yusufElnady/Ultrasound-Auxiliary-Board/BOMs/Sample-BOM_JLCSMT.xlsx

Designator | Footprint | Manufacturer Part Number
C1,C13,C20,C21,C28,C29 | Capacitor_SMD:C_0603_1608Metric | CL10A106KP8NNNC
C2,C3,C4,C9,C10,C11,C12,C16,C17,C18,C19,C22,C23,C24,C25,C26,C27,C30,C31,C32,C33,C34,C39,C49,C52,C54,C55,C56,C58,C89,C90,C96,C100,C103,C112,C113,C114,C115,C116,C117,C40,C41,C42,C43,C44,C45,C46,C69,C72,C73,C74,C75,C76,C77,C78,C79,C80,C81,C82,C83,C84,C85,C86,C111 | Capacitor_SMD:C_0603_1608Metric | CC0603KRX7R9BB104
C5,C6,C7,C8 | Capacitor_SMD:C_0603_1608Metric | CL10B105KP8NNNC
C14,C15 | Capacitor_SMD:C_0603_1608Metric | GRM1885C1H330JA01D
C35,C36,C37,C38,C57,C60,C63,C66 | Capacitor_SMD:C_0603_1608Metric | CL10C220JB8NNNC
C47,C48,C67,C68 | Capacitor_SMD:C_0603_1608Metric | CL10B223KB8NNNC
C50,C51,C61,C105 | Capacitor_SMD:C_0603_1608Metric | CL10B224KB8NNNC
C87 | Capacitor_SMD:C_1210_3225Metric | GRM32ER61C476KE15L
C88,C91,C92,C97,C98,C104,C109 | Capacitor_SMD:C_0805_2012Metric | CL21A106KAYNNNE
C93,C99,C101,C102,C107,C110 | Capacitor_SMD:C_0805_2012Metric | CL21A226MAYNNNE
C94 | Capacitor_SMD:C_0603_1608Metric | CL10B105KP8NNNC
C95 | Capacitor_SMD:C_0805_2012Metric | CL21A475KAQNNNE
C106 | Capacitor_SMD:C_0603_1608Metric | CL10B472KB8NNNC
C108 | Capacitor_SMD:C_0603_1608Metric | CL10C100JB8NNNC
D1,D2,D4,D5,D6,D7,D8 | LED_SMD:LED_0805_2012Metric | 17-21/GHC-YR1S2/4T
D3 | digikey-footprints:DO-214AC | B240A-13-F
D9,D10,D11,D12 | ESD8104MUTAG:DIO_ESD8104MUTAG | ESD8104MUTAG
F1 | 0154001.DR:FUSE_0154001.DR | 0154001.DR
J1,J2,J18,J19,J20,J21,J22,J23,J24,J25,J27 | Connector_PinHeader_2.54mm:PinHeader_1x02_P2.54mm_Vertical | PZ254V-11-02P
J3,J4,J5,J6,J7,J8,J9,J10 | CONSMA002-SMD:TE_CONSMA002-SMD | CONSMA002-SMD
J11 | Connector_PinHeader_2.54mm:PinHeader_1x03_P2.54mm_Vertical | PZ254V-11-03P
J12 | Connector_PinHeader_2.54mm:PinHeader_1x03_P2.54mm_Vertical | PZ254V-11-03P
J13 | digikey-footprints:PinHeader_1x3_P2.5mm_Drill1.1mm | PZ254V-11-03P
J14 | digikey-footprints:PinHeader_1x3_P2.5mm_Drill1.1mm | PZ254V-11-03P
J15 | Connector_PinHeader_2.54mm:PinHeader_1x07_P2.54mm_Vertical | PZ254V-11-07P
J16,J28 | Connector_PinHeader_2.54mm:PinHeader_2x04_P2.54mm_Vertical | PZ2.54V-1208P-H25
J17 | TerminalBlock:TerminalBlock_MaiXu_MX126-5.0-02P_1x02_P5.00mm | MX126-5.0-02P-GN01-Cu-S-A
J26 | Connector_PinHeader_2.54mm:PinHeader_1x02_P2.54mm_Vertical | PZ254V-11-02P
L1,L2,L3,L4 | Inductor_SMD:L_0805_2012Metric | MLF2012C101KT000
L5 | Inductor_SMD:L_0805_2012Metric | LQM21PN4R7MGRD
PS1,PS3 | TPSM84338RCJR:CONV_TPSM84338RCJR | TPSM84338RCJR
R1 | Resistor_SMD:R_0603_1608Metric | RP0603BRD0725RL
R2 | Resistor_SMD:R_0603_1608Metric | RC0603FR-07390RL
R3,R21,R22,R49,R50,R23,R24,R106,R115 | Resistor_SMD:R_0603_1608Metric | RC0603FR-0710KL
R4,R5,R6,R7,R8,R9,R10,R11,R12,R13,R14,R15,R16,R17,R18,R19,R31,R25,R26,R27,R28,R29,R30,R48,R101,R102,R83,R85,R87,R88,R91,R92,R97,R98,R110,R136,R137,R144,R146,R156 | Resistor_SMD:R_0603_1608Metric | RC0603FR-071KL
R20 | Resistor_SMD:R_0603_1608Metric | RC0603FR-072K2L
R32,R33,R34,R35,R44,R45,R46,R47 | Resistor_SMD:R_0603_1608Metric | CRCW0603280RFKEA
R36,R37,R42,R43,R141 | Resistor_SMD:R_0603_1608Metric | RC0603FR-07499RL
R38,R40,R41,R120,R121,R122,R123,R124,R125,R126,R127,R128,R129,R130,R131,R132,R133,R134,R135,R39 | Resistor_SMD:R_0603_1608Metric | CRCW060391R0FKEA
R51,R52,R55,R56,R59,R60,R62,R63,R67,R68,R70,R71,R78,R79,R81,R82 | Resistor_SMD:R_0603_1608Metric | RC0603FR-072K7L
R53,R54,R57,R58,R61,R64,R65,R66,R69,R72,R73,R74,R75,R76,R77,R80 | Resistor_SMD:R_0603_1608Metric | 0603WAF3901T5E
R84,R86,R89,R90,R93,R94,R95,R96 | Resistor_SMD:R_0603_1608Metric | 0603WAF2200T5E
R99,R100,R103,R104 | Resistor_SMD:R_0603_1608Metric | RT0603BRD073K57L
R105 | Resistor_SMD:R_0603_1608Metric | FRC0603F1073TS
R107,R112,R138 | Resistor_SMD:R_0603_1608Metric | 0603WAF2001T5E
R108,R111,R142,R143,R145,R154,R155 | Resistor_SMD:R_0603_1608Metric | RC0603FR-073KL
R109,R113 | Resistor_SMD:R_0603_1608Metric | RC0603FR-0718KL
R114 | Resistor_SMD:R_0603_1608Metric | AR03BTCX7202N
R116 | Resistor_SMD:R_0603_1608Metric | RC0603FR-0710RL
R117 | Resistor_SMD:R_0603_1608Metric | RT0603BRD07619KL
R118 | Resistor_SMD:R_0603_1608Metric | RC0603FR-07150KL
R119,R153 | Resistor_SMD:R_0603_1608Metric | RC0603FR-07100KL
R139,R140 | Resistor_SMD:R_0603_1608Metric | 0603WAF3300T5E
SW1 | Button_Switch_SMD:SW_Push_SPST_NO_Alps_SKRK | SH-TS-1185-2P-160gf
TP1,TP2,TP3,TP4,TP8,TP23,TP32,TP36,TP40,TP44,TP45,TP52,TP54,TP60,TP73,TP74,TP75,TP76,TP77,TP78,TP79 | digikey-footprints:PROBE_PAD_0805 | RCT-0C
U1,U4 | AD8334ACPZ:QFN50P900X900X100-65N | AD8334ACPZ
U2 | DSC1001DI2-125.0000T:CDFN4_2P5X2_MCH | DSC1001DI2-125.0000T
U3 | MAX14808ETK_:QFN50P1000X1000X80-69N | MAX14808ETK_
U5 | F280025PNS:PQFP_025PNSR_TEX | F280025PNS
U6 | Package_TO_SOT_SMD:SOT-23 | REF3030
U7 | MIC920YC5-TR:SOT65P210X110-5N | MIC920YC5-TR
U8,U9,U10,U11 | TLV9354IDR:SOIC_9354IDR_TEX | TLV9354IDR
U12 | TPS63700DRCR:VREG_V62_16624-01YE | TPS63700DRCR
U13 | M24M01E-FMN6TP:SO8N_4X5X1P27_STM | M24M01E-FMN6TP
U14 | LDL212PU50R:DFN_2PU50R_STM | LDL212PU50R
U15,U16 | Package_TO_SOT_SMD:SOT-223-3_TabPin2 | AZ1117CH2-3.3
U17 | TRS3221EIPWR:SOP65P640X120-16N | TRS3221EIPWR
U18,U19,U20 | BZX84C3V3TS-7-F:SOT-363_DIO | BZX84C3V3TS-7-F
U22,U23 | SOT_C3.3DT5G_ONS | ESD7C3.3DT5G
Y2 | KiCad:H130B16000183030EXTTR | H130B-16.000-18-3030-EXT-TR
