yusufElnady/Ultrasound-Auxiliary-Board/Ultrasound_NDT.kicad_pcb

## KiCad design Ultrasound_NDT.kicad_pcb (2026-05-07)

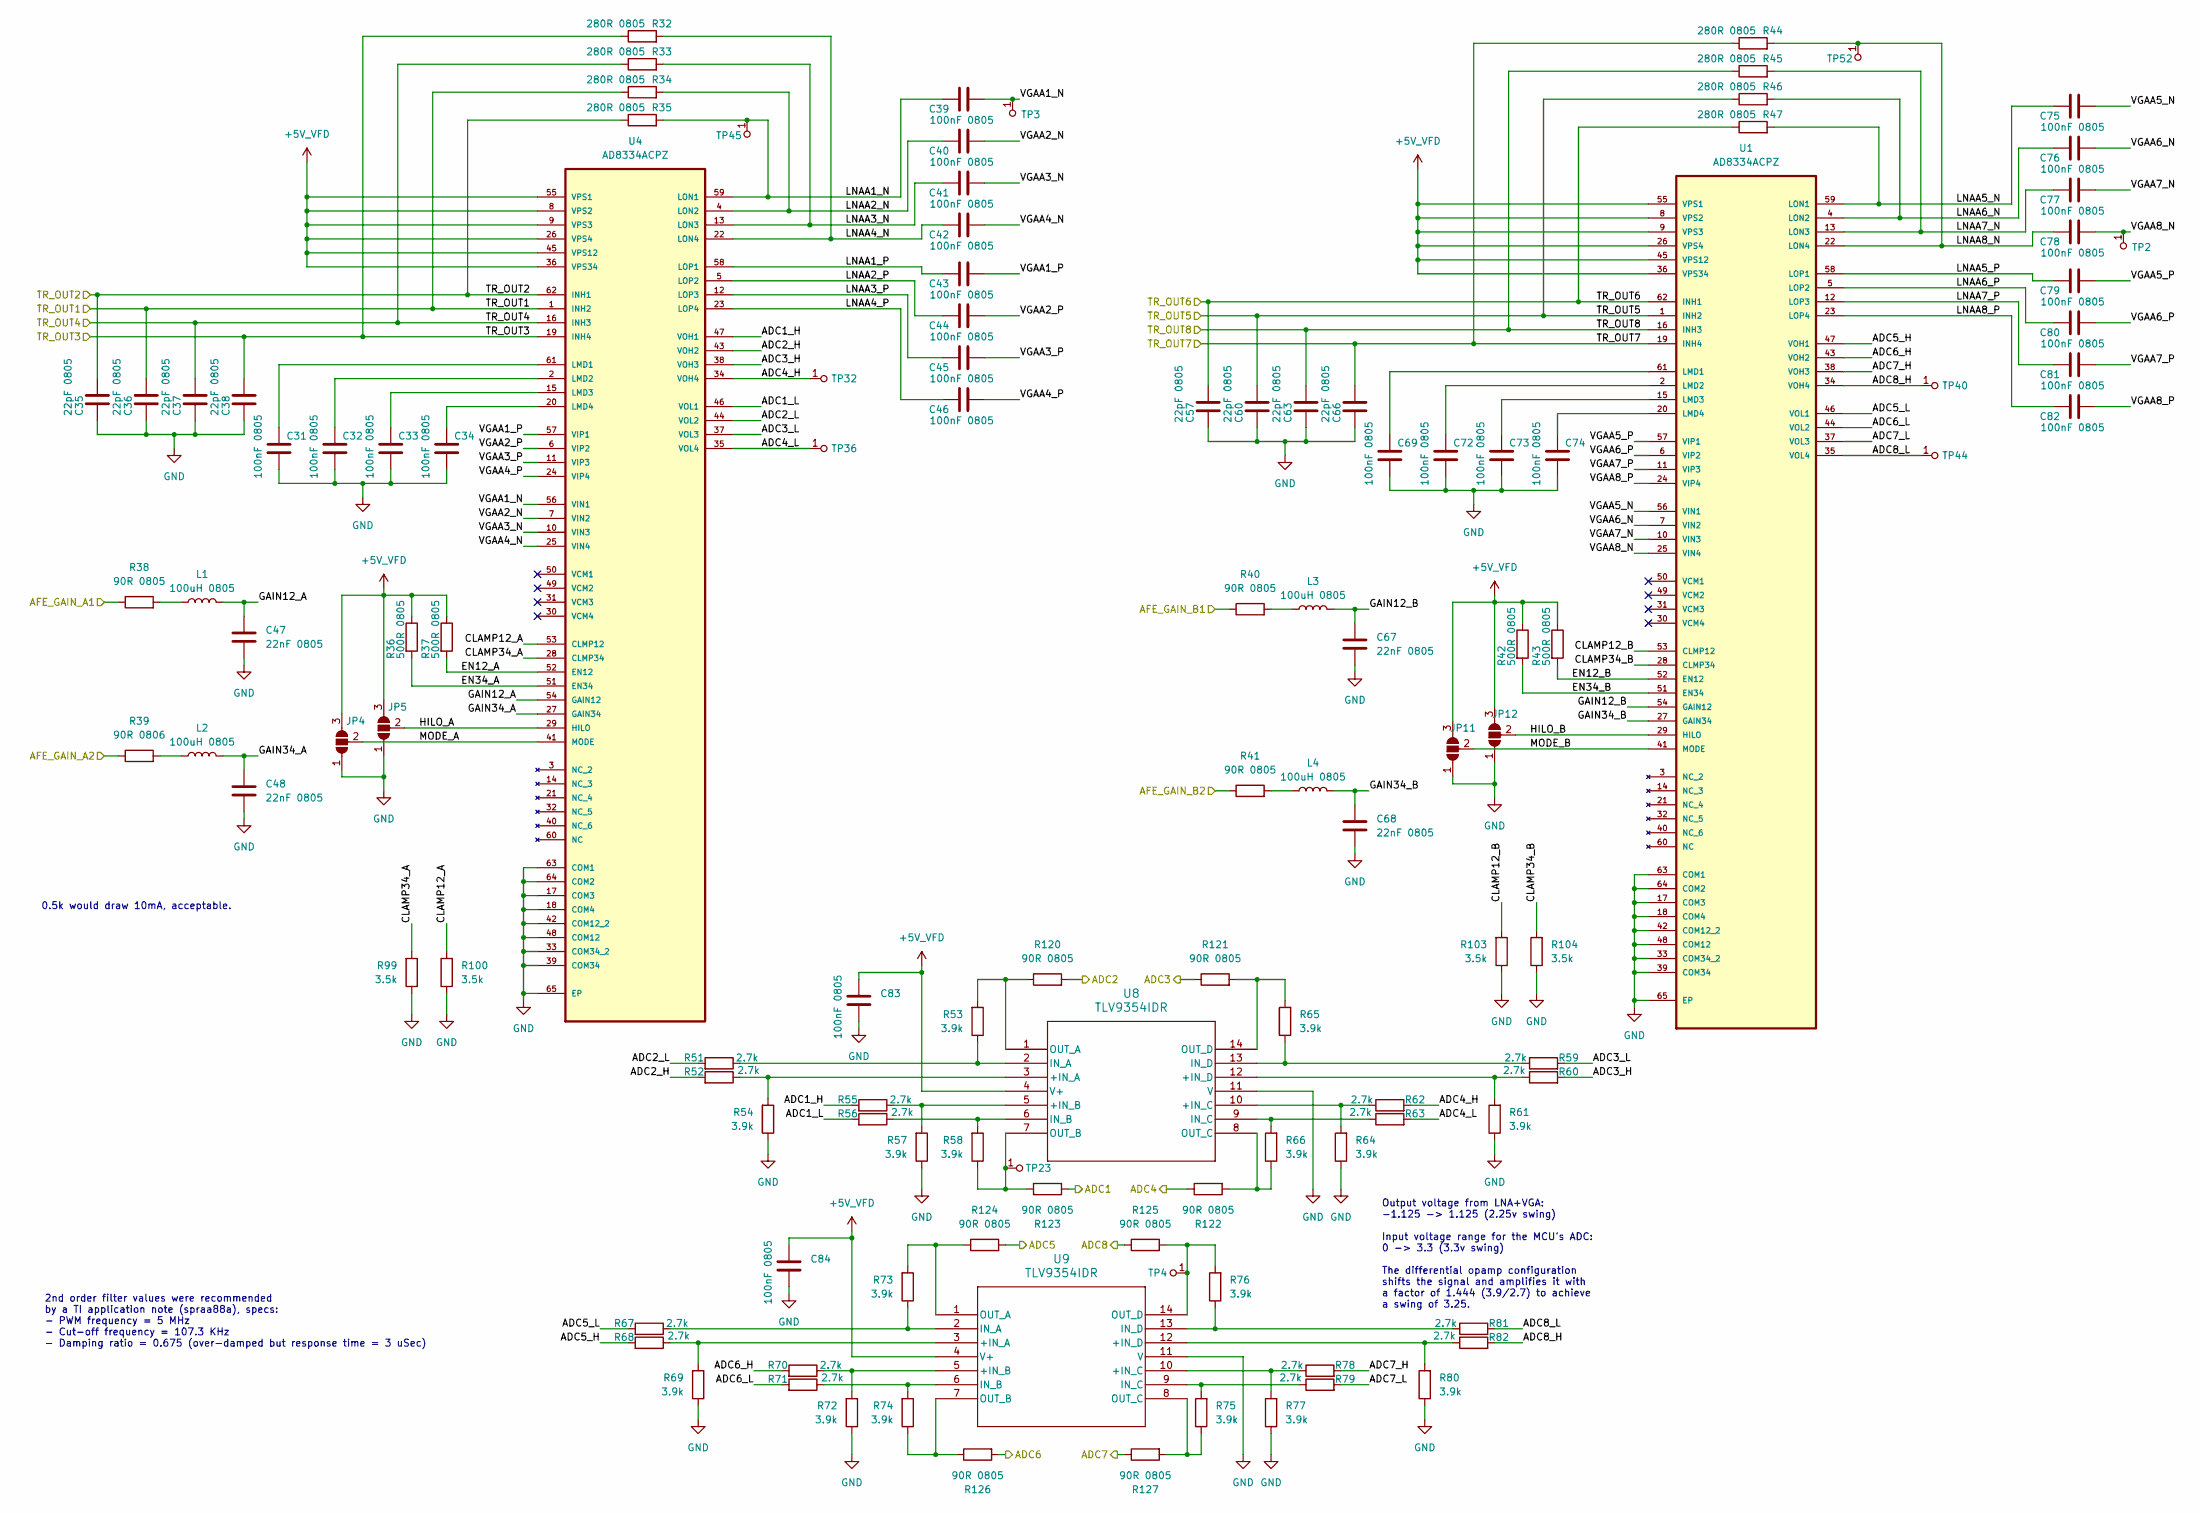
[picture p6: schematic receiver.kicad_sch]

Parts:
C31, C32, C33, C34, C39, C40, C41, C42, C43, C44, C45, C46, C69, C72, C73, C74, C75, C76, C77, C78, C79, C80, C81, C82, C83, C84: 100nF 0805; C_0603_1608Metric
C35, C36, C37, C38, C57, C60, C63, C66: 22pF 0805; C_0603_1608Metric
C47, C48, C67, C68: 22nF 0805; C_0603_1608Metric
JP4, JP5, JP11, JP12: SolderJumper_3_Open; SolderJumper-3_P1.3mm_Open_Pad1.0x1.5mm
L1, L2, L3, L4: 100uH 0805; L_0805_2012Metric
R32, R33, R34, R35, R44, R45, R46, R47: 280R 0805; R_0603_1608Metric
R36, R37, R42, R43: 500R 0805; R_0603_1608Metric
R38, R40, R41, R120, R121, R122, R123, R124, R125, R126, R127: 90R 0805; R_0603_1608Metric
R39: 90R 0806; R_0603_1608Metric
R51, R52, R55, R56, R59, R60, R62, R63, R67, R68, R70, R71, R78, R79, R81, R82: 2.7k; R_0603_1608Metric
R53, R54, R57, R58, R61, R64, R65, R66, R69, R72, R73, R74, R75, R76, R77, R80: 3.9k; R_0603_1608Metric
R99, R100, R103, R104: 3.5k; R_0603_1608Metric
TP2, TP3, TP4, TP23, TP32, TP36, TP40, TP44, TP45, TP52: RCT-0C; PROBE_PAD_0805; MPN RCT-0C; Digi-Key_PN A106144CT-ND
U1, U4: AD8334ACPZ; QFN50P900X900X100-65N; MPN AD8334ACPZ
U8, U9: TLV9354IDR; SOIC_9354IDR_TEX

Connections:
+5V_VFD: C83.1, C84.1, JP4.3 (B), JP5.3 (B), JP11.3 (B), JP12.3 (B), R36.1, R37.1, R42.1, R43.1, U1.8 (VPS2), U1.9 (VPS3), U1.26 (VPS4), U1.36 (VPS34), U1.45 (VPS12), U1.55 (VPS1), U4.8 (VPS2), U4.9 (VPS3), U4.26 (VPS4), U4.36 (VPS34), U4.45 (VPS12), U4.55 (VPS1), U8.4 (V+), U9.4 (V+); also elsewhere on the board
/Main MCU Section/ADC1: R123.2; also elsewhere on the board
/Main MCU Section/ADC2: R120.2; also elsewhere on the board
/Main MCU Section/ADC3: R121.1; also elsewhere on the board
/Main MCU Section/ADC4: R122.1; also elsewhere on the board
/Main MCU Section/ADC5: R124.2; also elsewhere on the board
/Main MCU Section/ADC6: R126.2; also elsewhere on the board
/Main MCU Section/ADC7: R127.1; also elsewhere on the board
/Main MCU Section/ADC8: R125.1; also elsewhere on the board
/Main MCU Section/AFE_GAIN_A1: R38.1; also elsewhere on the board
/Main MCU Section/AFE_GAIN_A2: R39.1; also elsewhere on the board
/Main MCU Section/AFE_GAIN_B1: R40.1; also elsewhere on the board
/Main MCU Section/AFE_GAIN_B2: R41.1; also elsewhere on the board
/Receiving Section/ADC1_H: R55.2, U4.47 (VOH1)
/Receiving Section/ADC1_L: R56.2, U4.46 (VOL1)
/Receiving Section/ADC2_H: R52.2, U4.43 (VOH2)
/Receiving Section/ADC2_L: R51.2, U4.44 (VOL2)
/Receiving Section/ADC3_H: R60.2, U4.38 (VOH3)
/Receiving Section/ADC3_L: R59.2, U4.37 (VOL3)
/Receiving Section/ADC4_H: R62.2, TP32.1, U4.34 (VOH4)
/Receiving Section/ADC4_L: R63.2, TP36.1, U4.35 (VOL4)
/Receiving Section/ADC5_H: R68.2, U1.47 (VOH1)
/Receiving Section/ADC5_L: R67.2, U1.46 (VOL1)
/Receiving Section/ADC6_H: R70.2, U1.43 (VOH2)
/Receiving Section/ADC6_L: R71.2, U1.44 (VOL2)
/Receiving Section/ADC7_H: R78.2, U1.38 (VOH3)
/Receiving Section/ADC7_L: R79.2, U1.37 (VOL3)
/Receiving Section/ADC8_H: R82.2, TP40.1, U1.34 (VOH4)
/Receiving Section/ADC8_L: R81.2, TP44.1, U1.35 (VOL4)
/Receiving Section/CLAMP12_A: R100.2, U4.53 (CLMP12)
/Receiving Section/CLAMP12_B: R103.2, U1.53 (CLMP12)
/Receiving Section/CLAMP34_A: R99.2, U4.28 (CLMP34)
/Receiving Section/CLAMP34_B: R104.2, U1.28 (CLMP34)
/Receiving Section/EN12_A: R37.2, U4.52 (EN12)
/Receiving Section/EN12_B: R43.2, U1.52 (EN12)
/Receiving Section/EN34_A: R36.2, U4.51 (EN34)
/Receiving Section/EN34_B: R42.2, U1.51 (EN34)
/Receiving Section/GAIN12_A: C47.1, L1.2, U4.54 (GAIN12)
/Receiving Section/GAIN12_B: C67.1, L3.2, U1.54 (GAIN12)
/Receiving Section/GAIN34_A: C48.1, L2.2, U4.27 (GAIN34)
/Receiving Section/GAIN34_B: C68.1, L4.2, U1.27 (GAIN34)
/Receiving Section/HILO_A: JP5.2 (C), U4.29 (HILO)
/Receiving Section/HILO_B: JP12.2 (C), U1.29 (HILO)
/Receiving Section/LNAA1_N: C39.1, R35.2, TP45.1, U4.59 (LON1)
/Receiving Section/LNAA1_P: C43.1, U4.58 (LOP1)
/Receiving Section/LNAA2_N: C40.1, R34.2, U4.4 (LON2)
/Receiving Section/LNAA2_P: C44.1, U4.5 (LOP2)
/Receiving Section/LNAA3_N: C41.1, R33.2, U4.13 (LON3)
/Receiving Section/LNAA3_P: C45.1, U4.12 (LOP3)
/Receiving Section/LNAA4_N: C42.1, R32.2, U4.22 (LON4)
/Receiving Section/LNAA4_P: C46.1, U4.23 (LOP4)
/Receiving Section/LNAA5_N: C75.1, R47.2, U1.59 (LON1)
/Receiving Section/LNAA5_P: C79.1, U1.58 (LOP1)
/Receiving Section/LNAA6_N: C76.1, R46.2, U1.4 (LON2)
/Receiving Section/LNAA6_P: C80.1, U1.5 (LOP2)
/Receiving Section/LNAA7_N: C77.1, R45.2, U1.13 (LON3)
/Receiving Section/LNAA7_P: C81.1, U1.12 (LOP3)
/Receiving Section/LNAA8_N: C78.1, R44.2, TP52.1, U1.22 (LON4)
/Receiving Section/LNAA8_P: C82.1, U1.23 (LOP4)
/Receiving Section/MODE_A: JP4.2 (C), U4.41 (MODE)
/Receiving Section/MODE_B: JP11.2 (C), U1.41 (MODE)
/Receiving Section/TR_OUT1: C36.1, R34.1, U4.1 (INH2); also elsewhere on the board
/Receiving Section/TR_OUT2: C35.1, R35.1, U4.62 (INH1); also elsewhere on the board
/Receiving Section/TR_OUT3: C38.1, R32.1, U4.19 (INH4); also elsewhere on the board
/Receiving Section/TR_OUT4: C37.1, R33.1, U4.16 (INH3); also elsewhere on the board
/Receiving Section/TR_OUT5: C60.1, R46.1, U1.1 (INH2); also elsewhere on the board
/Receiving Section/TR_OUT6: C57.1, R47.1, U1.62 (INH1); also elsewhere on the board
/Receiving Section/TR_OUT7: C66.1, R44.1, U1.19 (INH4); also elsewhere on the board
/Receiving Section/TR_OUT8: C63.1, R45.1, U1.16 (INH3); also elsewhere on the board
/Receiving Section/VGAA1_N: C39.2, TP3.1, U4.56 (VIN1)
/Receiving Section/VGAA1_P: C43.2, U4.57 (VIP1)
/Receiving Section/VGAA2_N: C40.2, U4.7 (VIN2)
/Receiving Section/VGAA2_P: C44.2, U4.6 (VIP2)
/Receiving Section/VGAA3_N: C41.2, U4.10 (VIN3)
/Receiving Section/VGAA3_P: C45.2, U4.11 (VIP3)
/Receiving Section/VGAA4_N: C42.2, U4.25 (VIN4)
/Receiving Section/VGAA4_P: C46.2, U4.24 (VIP4)
/Receiving Section/VGAA5_N: C75.2, U1.56 (VIN1)
/Receiving Section/VGAA5_P: C79.2, U1.57 (VIP1)
/Receiving Section/VGAA6_N: C76.2, U1.7 (VIN2)
/Receiving Section/VGAA6_P: C80.2, U1.6 (VIP2)
/Receiving Section/VGAA7_N: C77.2, U1.10 (VIN3)
/Receiving Section/VGAA7_P: C81.2, U1.11 (VIP3)
/Receiving Section/VGAA8_N: C78.2, TP2.1, U1.25 (VIN4)
/Receiving Section/VGAA8_P: C82.2, U1.24 (VIP4)
GND: C31.2, C32.2, C33.2, C34.2, C35.2, C36.2, C37.2, C38.2, C47.2, C48.2, C57.2, C60.2, C63.2, C66.2, C67.2, C68.2, C69.2, C72.2, C73.2, C74.2, C83.2, C84.2, JP4.1 (A), JP5.1 (A), JP11.1 (A), JP12.1 (A), R54.1, R57.1, R61.1, R64.1, R69.1, R72.1, R77.1, R80.1, R99.1, R100.1, R103.1, R104.1, U1.17 (COM3), U1.18 (COM4), U1.33 (COM34_2), U1.39 (COM34), U1.42 (COM12_2), U1.48 (COM12), U1.63 (COM1), U1.64 (COM2), U1.65 (EP), U4.17 (COM3), U4.18 (COM4), U4.33 (COM34_2), U4.39 (COM34), U4.42 (COM12_2), U4.48 (COM12), U4.63 (COM1), U4.64 (COM2), U4.65 (EP), U8.11 (V), U9.11 (V); also elsewhere on the board
unnamed: L1.1, R38.2
unnamed: L2.1, R39.2
unnamed: L3.1, R40.2
unnamed: L4.1, R41.2
unnamed: C69.1, U1.61 (LMD1)
unnamed: C72.1, U1.2 (LMD2)
unnamed: C73.1, U1.15 (LMD3)
unnamed: C74.1, U1.20 (LMD4)
unnamed: C31.1, U4.61 (LMD1)
unnamed: C32.1, U4.2 (LMD2)
unnamed: C33.1, U4.15 (LMD3)
unnamed: C34.1, U4.20 (LMD4)
unnamed: R52.1, R54.2, U8.3 (+IN_A)
unnamed: R55.1, R57.2, U8.5 (+IN_B)
unnamed: R62.1, R64.2, U8.10 (+IN_C)
unnamed: R60.1, R61.2, U8.12 (+IN_D)
unnamed: R51.1, R53.1, U8.2 (IN_A)
unnamed: R56.1, R58.2, U8.6 (IN_B)
unnamed: R63.1, R66.2, U8.9 (IN_C)
unnamed: R59.1, R65.1, U8.13 (IN_D)
unnamed: R53.2, R120.1, U8.1 (OUT_A)
unnamed: R58.1, R123.1, TP23.1, U8.7 (OUT_B)
unnamed: R66.1, R122.2, U8.8 (OUT_C)
unnamed: R65.2, R121.2, U8.14 (OUT_D)
unnamed: R68.1, R69.2, U9.3 (+IN_A)
unnamed: R70.1, R72.2, U9.5 (+IN_B)
unnamed: R77.2, R78.1, U9.10 (+IN_C)
unnamed: R80.2, R82.1, U9.12 (+IN_D)
unnamed: R67.1, R73.1, U9.2 (IN_A)
unnamed: R71.1, R74.2, U9.6 (IN_B)
unnamed: R75.2, R79.1, U9.9 (IN_C)
unnamed: R76.1, R81.1, U9.13 (IN_D)
unnamed: R73.2, R124.1, U9.1 (OUT_A)
unnamed: R74.1, R126.1, U9.7 (OUT_B)
unnamed: R75.1, R127.2, U9.8 (OUT_C)
unnamed: R76.2, R125.2, TP4.1, U9.14 (OUT_D)

Notes on the sheet:
Output voltage from LNA+VGA: -1.125 -> 1.125 (2.25v swing) Input voltage range for the MCU's ADC: 0 -> 3.3 (3.3v swing) The differential opamp configuration shifts the signal and amplifies it with a factor of 1.444 (3.9/2.7) to achieve a swing of 3.25.
2nd order filter values were recommended by a TI application note (spraa88a), specs: - PWM frequency = 5 MHz - Cut-off frequency = 107.3 KHz - Damping ratio = 0.675 (over-damped but response time = 3 uSec)
0.5k would draw 10mA, acceptable.

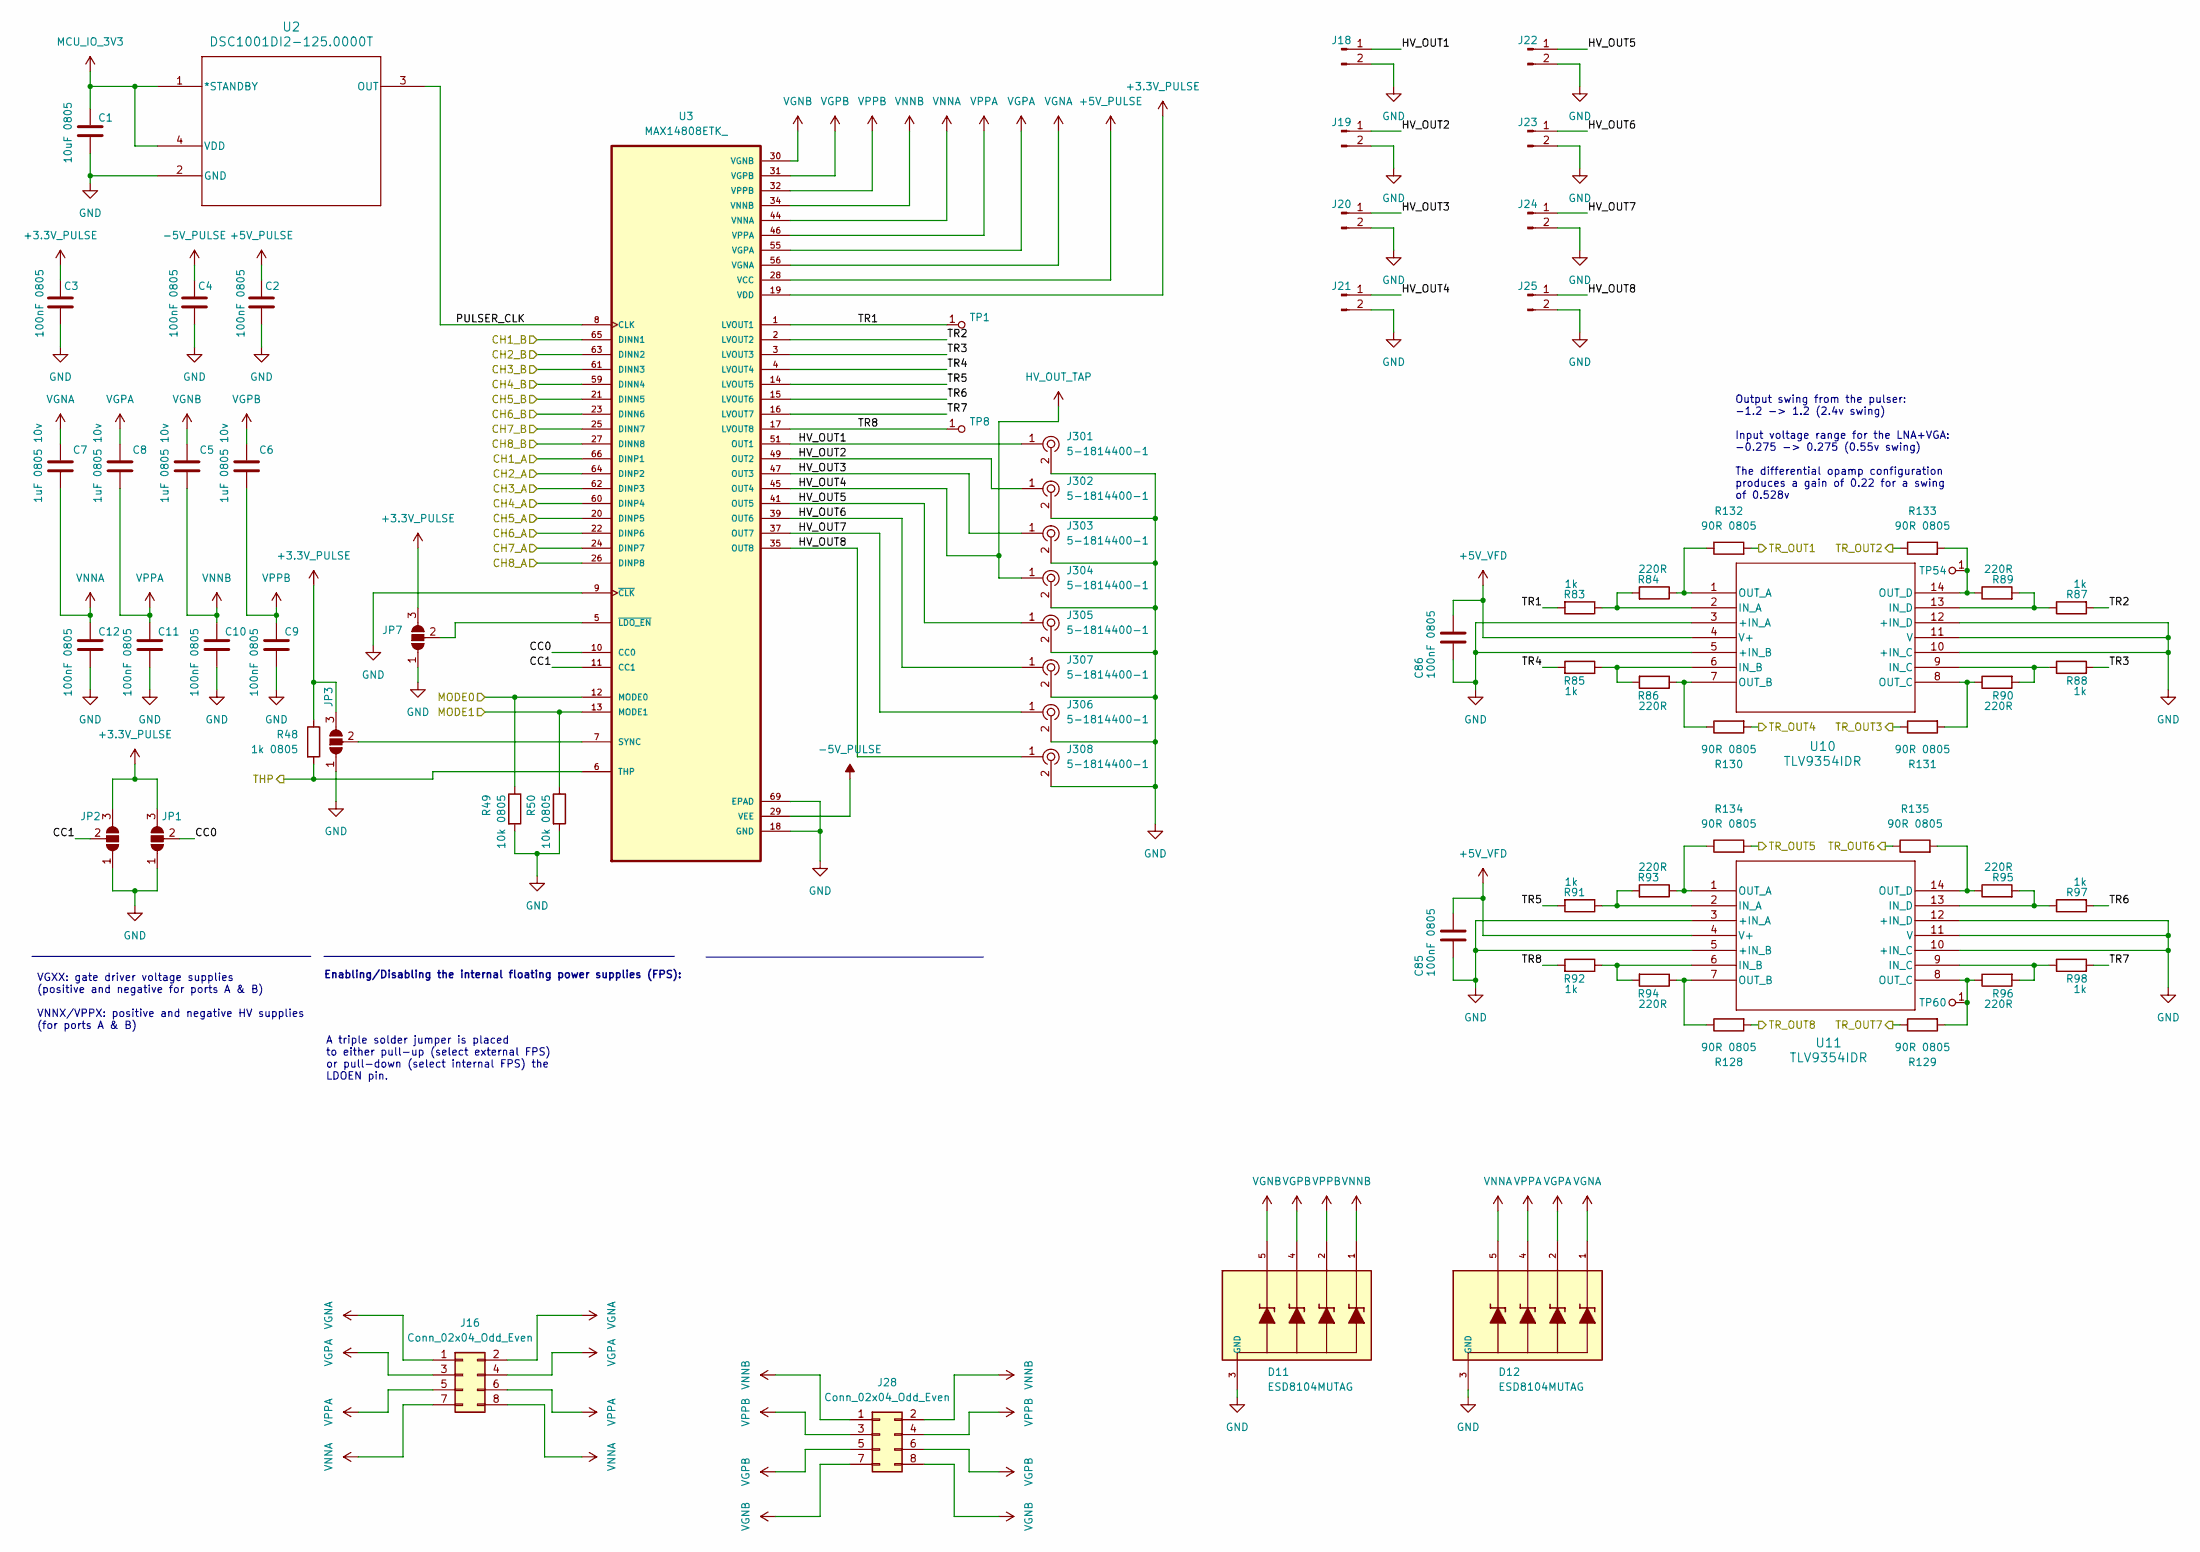
[picture p7: schematic pulser.kicad_sch]

Parts:
C1: 10uF 0805; C_0603_1608Metric
C2, C3, C4, C9, C10, C11, C12, C85, C86: 100nF 0805; C_0603_1608Metric
C5, C6, C7, C8: 1uF 0805 10v; C_0603_1608Metric
D11, D12: ESD8104MUTAG; DIO_ESD8104MUTAG; PARTREV 8
J16, J28: Conn_02x04_Odd_Even; PinHeader_2x04_P2.54mm_Vertical
J18, J19, J20, J21, J22, J23, J24, J25: Conn_01x02_Pin; PinHeader_1x02_P2.54mm_Vertical
J301, J302, J303, J304, J305, J306, J307, J308: 5-1814400-1; RF_SMA_RightAngle_5-1814400-1; MPN 5-1814400-1; Digi-Key_PN A97593-ND
JP1, JP2, JP3, JP7: SolderJumper_3_Open; SolderJumper-3_P1.3mm_Open_Pad1.0x1.5mm
R48: 1k 0805; R_0603_1608Metric
R49, R50: 10k 0805; R_0603_1608Metric
R83, R85, R87, R88, R91, R92, R97, R98: 1k; R_0603_1608Metric
R84, R86, R89, R90, R93, R94, R95, R96: 220R; R_0603_1608Metric
R128, R129, R130, R131, R132, R133, R134, R135: 90R 0805; R_0603_1608Metric
TP1, TP8, TP54, TP60: RCT-0C; PROBE_PAD_0805; MPN RCT-0C; Digi-Key_PN A106144CT-ND
U2: DSC1001DI2-125.0000T; CDFN4_2P5X2_MCH
U3: MAX14808ETK_; QFN50P1000X1000X80-69N
U10, U11: TLV9354IDR; SOIC_9354IDR_TEX

Connections:
+3.3V_PULSE: C3.1, JP1.3 (B), JP2.3 (B), JP3.3 (B), JP7.3 (B), R48.1, U3.19 (VDD), U3.67 (VDD); also elsewhere on the board
+5V_PULSE: C2.1, U3.28 (VCC), U3.58 (VCC); also elsewhere on the board
+5V_VFD: C85.1, C86.1, U10.4 (V+), U11.4 (V+); also elsewhere on the board
-5V_PULSE: C4.1, U3.29 (VEE), U3.57 (VEE); also elsewhere on the board
/Main MCU Section/CH1_A: U3.66 (DINP1); also elsewhere on the board
/Main MCU Section/CH1_B: U3.65 (DINN1); also elsewhere on the board
/Main MCU Section/CH2_A: U3.64 (DINP2); also elsewhere on the board
/Main MCU Section/CH2_B: U3.63 (DINN2); also elsewhere on the board
/Main MCU Section/CH3_A: U3.62 (DINP3); also elsewhere on the board
/Main MCU Section/CH3_B: U3.61 (DINN3); also elsewhere on the board
/Main MCU Section/CH4_A: U3.60 (DINP4); also elsewhere on the board
/Main MCU Section/CH4_B: U3.59 (DINN4); also elsewhere on the board
/Main MCU Section/CH5_A: U3.20 (DINP5); also elsewhere on the board
/Main MCU Section/CH5_B: U3.21 (DINN5); also elsewhere on the board
/Main MCU Section/CH6_A: U3.22 (DINP6); also elsewhere on the board
/Main MCU Section/CH6_B: U3.23 (DINN6); also elsewhere on the board
/Main MCU Section/CH7_A: U3.24 (DINP7); also elsewhere on the board
/Main MCU Section/CH7_B: U3.25 (DINN7); also elsewhere on the board
/Main MCU Section/CH8_A: U3.26 (DINP8); also elsewhere on the board
/Main MCU Section/CH8_B: U3.27 (DINN8); also elsewhere on the board
/Main MCU Section/MODE0: R49.1, U3.12 (MODE0); also elsewhere on the board
/Main MCU Section/MODE1: R50.1, U3.13 (MODE1); also elsewhere on the board
/Main MCU Section/THP: R48.2, U3.6 (THP); also elsewhere on the board
/Pulsing Section/CC0: JP1.2 (C), U3.10 (CC0)
/Pulsing Section/CC1: JP2.2 (C), U3.11 (CC1)
/Pulsing Section/HV_OUT1: J18.1, J301.1, U3.51 (OUT1)
/Pulsing Section/HV_OUT2: J19.1, J302.1, U3.49 (OUT2)
/Pulsing Section/HV_OUT3: J20.1, J303.1, U3.47 (OUT3)
/Pulsing Section/HV_OUT5: J22.1, J305.1, U3.41 (OUT5)
/Pulsing Section/HV_OUT6: J23.1, J307.1, U3.39 (OUT6)
/Pulsing Section/HV_OUT7: J24.1, J306.1, U3.37 (OUT7)
/Pulsing Section/HV_OUT8: J25.1, J308.1, U3.35 (OUT8)
/Pulsing Section/PULSER_CLK: U2.3 (OUT), U3.8 (CLK)
/Pulsing Section/TR1: R83.2, TP1.1, U3.1 (LVOUT1)
/Pulsing Section/TR2: R87.2, U3.2 (LVOUT2)
/Pulsing Section/TR3: R88.2, U3.3 (LVOUT3)
/Pulsing Section/TR4: R85.2, U3.4 (LVOUT4)
/Pulsing Section/TR5: R91.2, U3.14 (LVOUT5)
/Pulsing Section/TR6: R97.2, U3.15 (LVOUT6)
/Pulsing Section/TR7: R98.2, U3.16 (LVOUT7)
/Pulsing Section/TR8: R92.2, TP8.1, U3.17 (LVOUT8)
/Receiving Section/TR_OUT1: R132.2; also elsewhere on the board
/Receiving Section/TR_OUT2: R133.1; also elsewhere on the board
/Receiving Section/TR_OUT3: R131.1; also elsewhere on the board
/Receiving Section/TR_OUT4: R130.2; also elsewhere on the board
/Receiving Section/TR_OUT5: R134.2; also elsewhere on the board
/Receiving Section/TR_OUT6: R135.1; also elsewhere on the board
/Receiving Section/TR_OUT7: R129.1; also elsewhere on the board
/Receiving Section/TR_OUT8: R128.2; also elsewhere on the board
GND: C1.2, C2.2, C3.2, C4.2, C9.2, C10.2, C11.2, C12.2, C85.2, C86.2, D11.3 (GND), D11.8 (GND), D12.3 (GND), D12.8 (GND), J18.2, J19.2, J20.2, J21.2, J22.2, J23.2, J24.2, J25.2, J301.2, J302.2, J303.2, J304.2, J305.2, J306.2, J307.2, J308.2, JP1.1 (A), JP2.1 (A), JP3.1 (A), JP7.1 (A), R49.2, R50.2, U2.2 (GND), U3.9 (~CLK), U3.18 (GND), U3.33 (GND), U3.43 (GND), U3.53 (GND), U3.68 (GND), U3.69 (EPAD), U10.3 (+IN_A), U10.5 (+IN_B), U10.10 (+IN_C), U10.11 (V), U10.12 (+IN_D), U11.3 (+IN_A), U11.5 (+IN_B), U11.10 (+IN_C), U11.11 (V), U11.12 (+IN_D); also elsewhere on the board
HV_OUT_TAP: J21.1, J304.1, U3.45 (OUT4)
MCU_IO_3V3: C1.1, U2.1 (*STANDBY), U2.4 (VDD); also elsewhere on the board
unnamed: JP3.2 (C), U3.7 (SYNC)
unnamed: JP7.2 (C), U3.5 (~LDO_EN)
unnamed: R83.1, R84.2, U10.2 (IN_A)
unnamed: R85.1, R86.2, U10.6 (IN_B)
unnamed: R88.1, R90.2, U10.9 (IN_C)
unnamed: R87.1, R89.2, U10.13 (IN_D)
unnamed: R84.1, R132.1, U10.1 (OUT_A)
unnamed: R86.1, R130.1, U10.7 (OUT_B)
unnamed: R90.1, R131.2, U10.8 (OUT_C)
unnamed: R89.1, R133.2, TP54.1, U10.14 (OUT_D)
unnamed: R91.1, R93.2, U11.2 (IN_A)
unnamed: R92.1, R94.2, U11.6 (IN_B)
unnamed: R96.2, R98.1, U11.9 (IN_C)
unnamed: R95.2, R97.1, U11.13 (IN_D)
unnamed: R93.1, R134.1, U11.1 (OUT_A)
unnamed: R94.1, R128.1, U11.7 (OUT_B)
unnamed: R96.1, R129.2, TP60.1, U11.8 (OUT_C)
unnamed: R95.1, R135.2, U11.14 (OUT_D)
VGNA: C7.1, D12.1, J16.1, J16.2, U3.56 (VGNA)
VGNB: C5.1, D11.5, J28.7, J28.8, U3.30 (VGNB)
VGPA: C8.1, D12.2, J16.3, J16.4, U3.55 (VGPA)
VGPB: C6.1, D11.4, J28.5, J28.6, U3.31 (VGPB)
VNNA: C7.2, C12.1, D12.5, J16.7, J16.8, U3.44 (VNNA), U3.48 (VNNA), U3.52 (VNNA)
VNNB: C5.2, C10.1, D11.1, J28.1, J28.2, U3.34 (VNNB), U3.38 (VNNB), U3.42 (VNNB)
VPPA: C8.2, C11.1, D12.4, J16.5, J16.6, U3.46 (VPPA), U3.50 (VPPA), U3.54 (VPPA)
VPPB: C6.2, C9.1, D11.2, J28.3, J28.4, U3.32 (VPPB), U3.36 (VPPB), U3.40 (VPPB); also elsewhere on the board

Notes on the sheet:
Output swing from the pulser: -1.2 -> 1.2 (2.4v swing) Input voltage range for the LNA+VGA: -0.275 -> 0.275 (0.55v swing) The differential opamp configuration produces a gain of 0.22 for a swing of 0.528v
VGXX: gate driver voltage supplies (positive and negative for ports A & B) VNNX/VPPX: positive and negative HV supplies (for ports A & B)
Enabling/Disabling the internal floating power supplies (FPS):
A triple solder jumper is placed to either pull-up (select external FPS) or pull-down (select internal FPS) the LDOEN pin.
