yusufElnady/Ultrasound-Auxiliary-Board/Ultrasound_NDT.kicad_pcb

## KiCad design Ultrasound_NDT.kicad_pcb (continued)

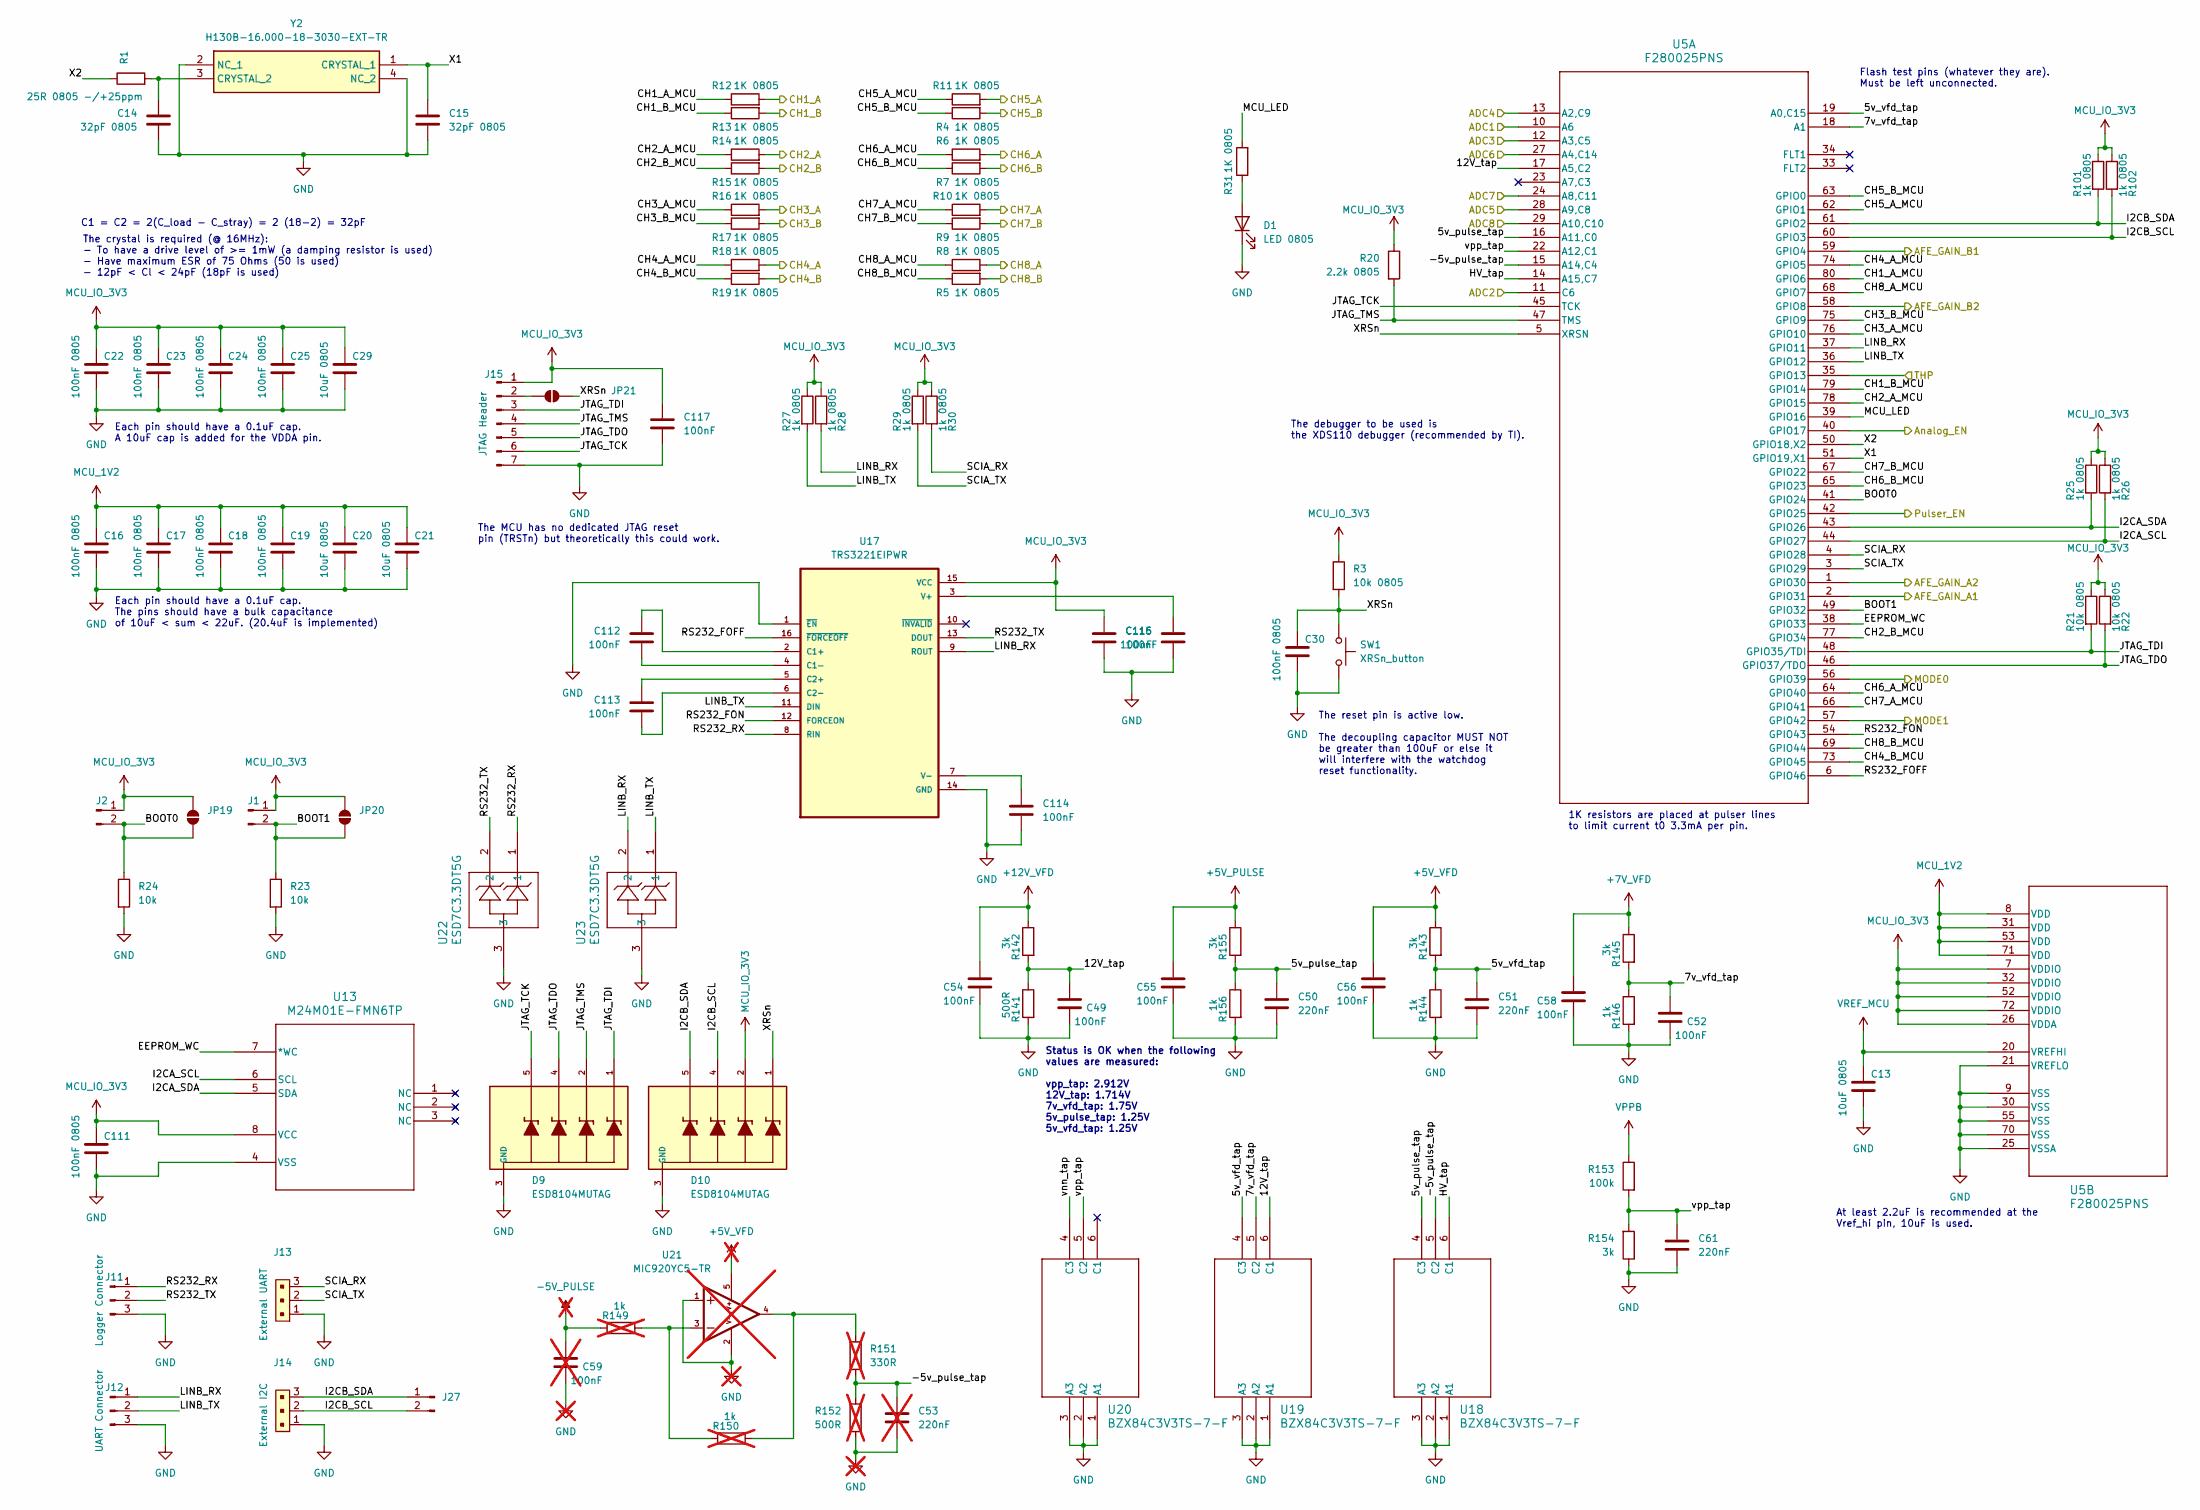
[picture p8: schematic MCU.kicad_sch]

Parts:
C13, C20, C21, C29: 10uF 0805; C_0603_1608Metric
C14, C15: 32pF 0805; C_0603_1608Metric
C16, C17, C18, C19, C22, C23, C24, C25, C30, C111: 100nF 0805; C_0603_1608Metric
C49, C52, C54, C55, C56, C58, C112, C113, C114, C115, C116, C117: 100nF; C_0603_1608Metric
C50, C51, C61: 220nF; C_0603_1608Metric
C53: 220nF; C_0603_1608Metric; not fitted
C59: 100nF; C_0603_1608Metric; not fitted
D1: LED 0805; LED_0805_2012Metric
D9, D10: ESD8104MUTAG; DIO_ESD8104MUTAG; PARTREV 8
J1, J2, J27: Conn_01x02_Pin; PinHeader_1x02_P2.54mm_Vertical
J11: Logger Connector; PinHeader_1x03_P2.54mm_Vertical
J12: UART Connector; PinHeader_1x03_P2.54mm_Vertical
J13: External UART; PinHeader_1x3_P2.5mm_Drill1.1mm; MPN B3B-XH-A(LF)(SN); Digi-Key_PN 455-2248-ND
J14: External I2C; PinHeader_1x3_P2.5mm_Drill1.1mm; MPN B3B-XH-A(LF)(SN); Digi-Key_PN 455-2248-ND
J15: JTAG Header; PinHeader_1x07_P2.54mm_Vertical
JP19, JP20, JP21: SolderJumper_2_Open; SolderJumper-2_P1.3mm_Open_Pad1.0x1.5mm
R1: 25R 0805 -/+25ppm; R_0603_1608Metric
R3, R21, R22: 10k 0805; R_0603_1608Metric
R4, R5, R6, R7, R8, R9, R10, R11, R12, R13, R14, R15, R16, R17, R18, R19, R31: 1K 0805; R_0603_1608Metric
R20: 2.2k 0805; R_0603_1608Metric
R23, R24: 10k; R_0603_1608Metric
R25, R26, R27, R28, R29, R30, R101, R102: 1k 0805; R_0603_1608Metric
R141: 500R; R_0603_1608Metric
R142, R143, R145, R154, R155: 3k; R_0603_1608Metric
R144, R146, R156: 1k; R_0603_1608Metric
R149, R150: 1k; R_0603_1608Metric; not fitted
R151: 330R; R_0603_1608Metric; not fitted
R152: 500R; R_0603_1608Metric; not fitted
R153: 100k; R_0603_1608Metric
SW1: XRSn_button; SW_Push_SPST_NO_Alps_SKRK
U5: F280025PNS; PQFP_025PNSR_TEX
U13: M24M01E-FMN6TP; SO8N_4X5X1P27_STM
U17: TRS3221EIPWR; SOP65P640X120-16N
U18, U19, U20: BZX84C3V3TS-7-F; SOT-363_DIO
U21: MIC920YC5-TR; SOT65P210X110-5N; PARTREV March 2006; not fitted
U22, U23: ESD7C3.3DT5G; SOT_C3.3DT5G_ONS
Y2: H130B-16.000-18-3030-EXT-TR; H130B16000183030EXTTR; Manufacturer_Part_Number H130B-16.000-18-3030-EXT-TR

Connections:
+5V_PULSE: C55.1, R155.1; also elsewhere on the board
+5V_VFD: C56.1, R143.1, U21.5; also elsewhere on the board
+7V_VFD: C58.1, R145.1; also elsewhere on the board
+12V_VFD: C54.1, R142.1; also elsewhere on the board
/Main MCU Section/5v_pulse_tap: C50.1, R155.2, R156.1, U5.16 (A11,C0), U18.4 (C3)
/Main MCU Section/5v_vfd_tap: C51.1, R143.2, R144.1, U5.19 (A0,C15), U19.4 (C3)
/Main MCU Section/7v_vfd_tap: C52.1, R145.2, R146.1, U5.18 (A1), U19.5 (C2)
/Main MCU Section/12V_tap: C49.1, R141.1, R142.2, U5.17 (A5,C2), U19.6 (C1)
/Main MCU Section/-5v_pulse_tap: C53.1, R151.1, R152.2, U5.15 (A14,C4), U18.5 (C2)
/Main MCU Section/ADC1: U5.10 (A6); also elsewhere on the board
/Main MCU Section/ADC2: U5.11 (C6); also elsewhere on the board
/Main MCU Section/ADC3: U5.12 (A3,C5); also elsewhere on the board
/Main MCU Section/ADC4: U5.13 (A2,C9); also elsewhere on the board
/Main MCU Section/ADC5: U5.28 (A9,C8); also elsewhere on the board
/Main MCU Section/ADC6: U5.27 (A4,C14); also elsewhere on the board
/Main MCU Section/ADC7: U5.24 (A8,C11); also elsewhere on the board
/Main MCU Section/ADC8: U5.29 (A10,C10); also elsewhere on the board
/Main MCU Section/AFE_GAIN_A1: U5.2 (GPIO31); also elsewhere on the board
/Main MCU Section/AFE_GAIN_A2: U5.1 (GPIO30); also elsewhere on the board
/Main MCU Section/AFE_GAIN_B1: U5.59 (GPIO4); also elsewhere on the board
/Main MCU Section/AFE_GAIN_B2: U5.58 (GPIO8); also elsewhere on the board
/Main MCU Section/Analog_EN: U5.40 (GPIO17); also elsewhere on the board
/Main MCU Section/BOOT0: J2.2, JP19.1 (A), R24.1, U5.41 (GPIO24)
/Main MCU Section/BOOT1: J1.2, JP20.1 (A), R23.1, U5.49 (GPIO32)
/Main MCU Section/CH1_A: R12.2; also elsewhere on the board
/Main MCU Section/CH1_A_MCU: R12.1, U5.80 (GPIO6)
/Main MCU Section/CH1_B: R13.2; also elsewhere on the board
/Main MCU Section/CH1_B_MCU: R13.1, U5.79 (GPIO14)
/Main MCU Section/CH2_A: R14.2; also elsewhere on the board
/Main MCU Section/CH2_A_MCU: R14.1, U5.78 (GPIO15)
/Main MCU Section/CH2_B: R15.2; also elsewhere on the board
/Main MCU Section/CH2_B_MCU: R15.1, U5.77 (GPIO34)
/Main MCU Section/CH3_A: R16.2; also elsewhere on the board
/Main MCU Section/CH3_A_MCU: R16.1, U5.76 (GPIO10)
/Main MCU Section/CH3_B: R17.2; also elsewhere on the board
/Main MCU Section/CH3_B_MCU: R17.1, U5.75 (GPIO9)
/Main MCU Section/CH4_A: R18.2; also elsewhere on the board
/Main MCU Section/CH4_A_MCU: R18.1, U5.74 (GPIO5)
/Main MCU Section/CH4_B: R19.2; also elsewhere on the board
/Main MCU Section/CH4_B_MCU: R19.1, U5.73 (GPIO45)
/Main MCU Section/CH5_A: R11.2; also elsewhere on the board
/Main MCU Section/CH5_A_MCU: R11.1, U5.62 (GPIO1)
/Main MCU Section/CH5_B: R4.2; also elsewhere on the board
/Main MCU Section/CH5_B_MCU: R4.1, U5.63 (GPIO0)
/Main MCU Section/CH6_A: R6.2; also elsewhere on the board
/Main MCU Section/CH6_A_MCU: R6.1, U5.64 (GPIO40)
/Main MCU Section/CH6_B: R7.2; also elsewhere on the board
/Main MCU Section/CH6_B_MCU: R7.1, U5.65 (GPIO23)
/Main MCU Section/CH7_A: R10.2; also elsewhere on the board
/Main MCU Section/CH7_A_MCU: R10.1, U5.66 (GPIO41)
/Main MCU Section/CH7_B: R9.2; also elsewhere on the board
/Main MCU Section/CH7_B_MCU: R9.1, U5.67 (GPIO22)
/Main MCU Section/CH8_A: R8.2; also elsewhere on the board
/Main MCU Section/CH8_A_MCU: R8.1, U5.68 (GPIO7)
/Main MCU Section/CH8_B: R5.2; also elsewhere on the board
/Main MCU Section/CH8_B_MCU: R5.1, U5.69 (GPIO44)
/Main MCU Section/EEPROM_WC: U5.38 (GPIO33), U13.7 (*WC)
/Main MCU Section/HV_tap: U5.14 (A15,C7), U18.6 (C1)
/Main MCU Section/I2CA_SCL: R26.2, U5.44 (GPIO27), U13.6 (SCL)
/Main MCU Section/I2CA_SDA: R25.2, U5.43 (GPIO26), U13.5 (SDA)
/Main MCU Section/I2CB_SCL: D10.4, J14.2, J27.2, R102.2, U5.60 (GPIO3)
/Main MCU Section/I2CB_SDA: D10.5, J14.3, J27.1, R101.2, U5.61 (GPIO2)
/Main MCU Section/JTAG_TCK: D9.5, J15.6, U5.45 (TCK)
/Main MCU Section/JTAG_TDI: D9.1, J15.3, R21.2, U5.48 (GPIO35/TDI)
/Main MCU Section/JTAG_TDO: D9.4, J15.5, R22.2, U5.46 (GPIO37/TDO)
/Main MCU Section/JTAG_TMS: D9.2, J15.4, R20.2, U5.47 (TMS)
/Main MCU Section/LINB_RX: J12.1, R28.2, U5.37 (GPIO11), U17.9 (ROUT), U23.2
/Main MCU Section/LINB_TX: J12.2, R27.2, U5.36 (GPIO12), U17.11 (DIN), U23.1
/Main MCU Section/MCU_LED: R31.2, U5.39 (GPIO16)
/Main MCU Section/MODE0: U5.56 (GPIO39); also elsewhere on the board
/Main MCU Section/MODE1: U5.57 (GPIO42); also elsewhere on the board
/Main MCU Section/Pulser_EN: U5.42 (GPIO25); also elsewhere on the board
/Main MCU Section/RS232_FOFF: U5.6 (GPIO46), U17.16 (~FORCEOFF)
/Main MCU Section/RS232_FON: U5.54 (GPIO43), U17.12 (FORCEON)
/Main MCU Section/RS232_RX: J11.1, U17.8 (RIN), U22.1
/Main MCU Section/RS232_TX: J11.2, U17.13 (DOUT), U22.2
/Main MCU Section/SCIA_RX: J13.3, R30.2, U5.4 (GPIO28)
/Main MCU Section/SCIA_TX: J13.2, R29.2, U5.3 (GPIO29)
/Main MCU Section/THP: U5.35 (GPIO13); also elsewhere on the board
/Main MCU Section/X1: C15.1, U5.51 (GPIO19,X1), Y2.1 (CRYSTAL_1)
/Main MCU Section/X2: R1.1, U5.50 (GPIO18,X2)
/Main MCU Section/XRSn: C30.1, D10.1, JP21.2 (B), R3.2, SW1.1, U5.5 (XRSN)
/Main MCU Section/vnn_tap: U20.4 (C3)
/Main MCU Section/vpp_tap: C61.1, R153.2, R154.2, U5.22 (A12,C1), U20.5 (C2)
GND: C13.2, C14.2, C15.2, C16.2, C17.2, C18.2, C19.2, C20.2, C21.2, C22.2, C23.2, C24.2, C25.2, C29.2, C30.2, C49.2, C50.2, C51.2, C52.2, C53.2, C54.2, C55.2, C56.2, C58.2, C59.2, C61.2, C111.2, C114.2, C115.2, C116.2, C117.2, D1.1 (K), D9.3 (GND), D9.8 (GND), D10.3 (GND), D10.8 (GND), J11.3, J12.3, J13.1, J14.1, J15.7, R23.2, R24.2, R141.2, R144.2, R146.2, R152.1, R154.1, R156.2, SW1.2, U5.9 (VSS), U5.21 (VREFLO), U5.25 (VSSA), U5.30 (VSS), U5.55 (VSS), U5.70 (VSS), U13.4 (VSS), U17.1 (~EN), U17.14 (GND), U18.1 (A1), U18.2 (A2), U18.3 (A3), U19.1 (A1), U19.2 (A2), U19.3 (A3), U20.1 (A1), U20.2 (A2), U20.3 (A3), U21.1, U21.2, U22.3, U23.3, Y2.2 (NC_1), Y2.4 (NC_2); also elsewhere on the board
MCU_1V2: C16.1, C17.1, C18.1, C19.1, C20.1, C21.1, U5.8 (VDD), U5.31 (VDD), U5.53 (VDD), U5.71 (VDD)
MCU_IO_3V3: C22.1, C23.1, C24.1, C25.1, C29.1, C111.1, C116.1, C117.1, D10.2, J1.1, J2.1, J15.1, JP19.2 (B), JP20.2 (B), R3.1, R20.1, R21.1, R22.1, R25.1, R26.1, R27.1, R28.1, R29.1, R30.1, R101.1, R102.1, U5.7 (VDDIO), U5.26 (VDDA), U5.32 (VDDIO), U5.52 (VDDIO), U5.72 (VDDIO), U13.8 (VCC), U17.15 (VCC); also elsewhere on the board
unnamed: C59.1, R149.2
unnamed: D1.2 (A), R31.1
unnamed: J15.2, JP21.1 (A)
unnamed: R149.1, R150.2, U21.3
unnamed: R150.1, R151.2, U21.4
unnamed: C112.1, U17.2 (C1+)
unnamed: C112.2, U17.4 (C1-)
unnamed: C113.1, U17.5 (C2+)
unnamed: C113.2, U17.6 (C2-)
unnamed: C115.1, U17.3 (V+)
unnamed: C114.1, U17.7 (V-)
unnamed: C14.1, R1.2, Y2.3 (CRYSTAL_2)
VPPB: R153.1; also elsewhere on the board
VREF_MCU: C13.1, U5.20 (VREFHI); also elsewhere on the board

Notes on the sheet:
Status is OK when the following values are measured: vpp_tap: 2.912V 12V_tap: 1.714V 7v_vfd_tap: 1.75V 5v_pulse_tap: 1.25V 5v_vfd_tap: 1.25V
The crystal is required (@ 16MHz): - To have a drive level of >= 1mW (a damping resistor is used) - Have maximum ESR of 75 Ohms (50 is used) - 12pF < Cl < 24pF (18pF is used)
Each pin should have a 0.1uF cap. The pins should have a bulk capacitance of 10uF < sum < 22uF. (20.4uF is implemented)
Each pin should have a 0.1uF cap. A 10uF cap is added for the VDDA pin.
The debugger to be used is the XDS110 debugger (recommended by TI).
The MCU has no dedicated JTAG reset pin (TRSTn) but theoretically this could work.
At least 2.2uF is recommended at the Vref_hi pin, 10uF is used.
1K resistors are placed at pulser lines to limit current t0 3.3mA per pin.
The reset pin is active low. The decoupling capacitor MUST NOT be greater than 100uF or else it will interfere with the watchdog reset functionality.
Flash test pins (whatever they are). Must be left unconnected.
C1 = C2 = 2(C_load - C_stray) = 2 (18-2) = 32pF

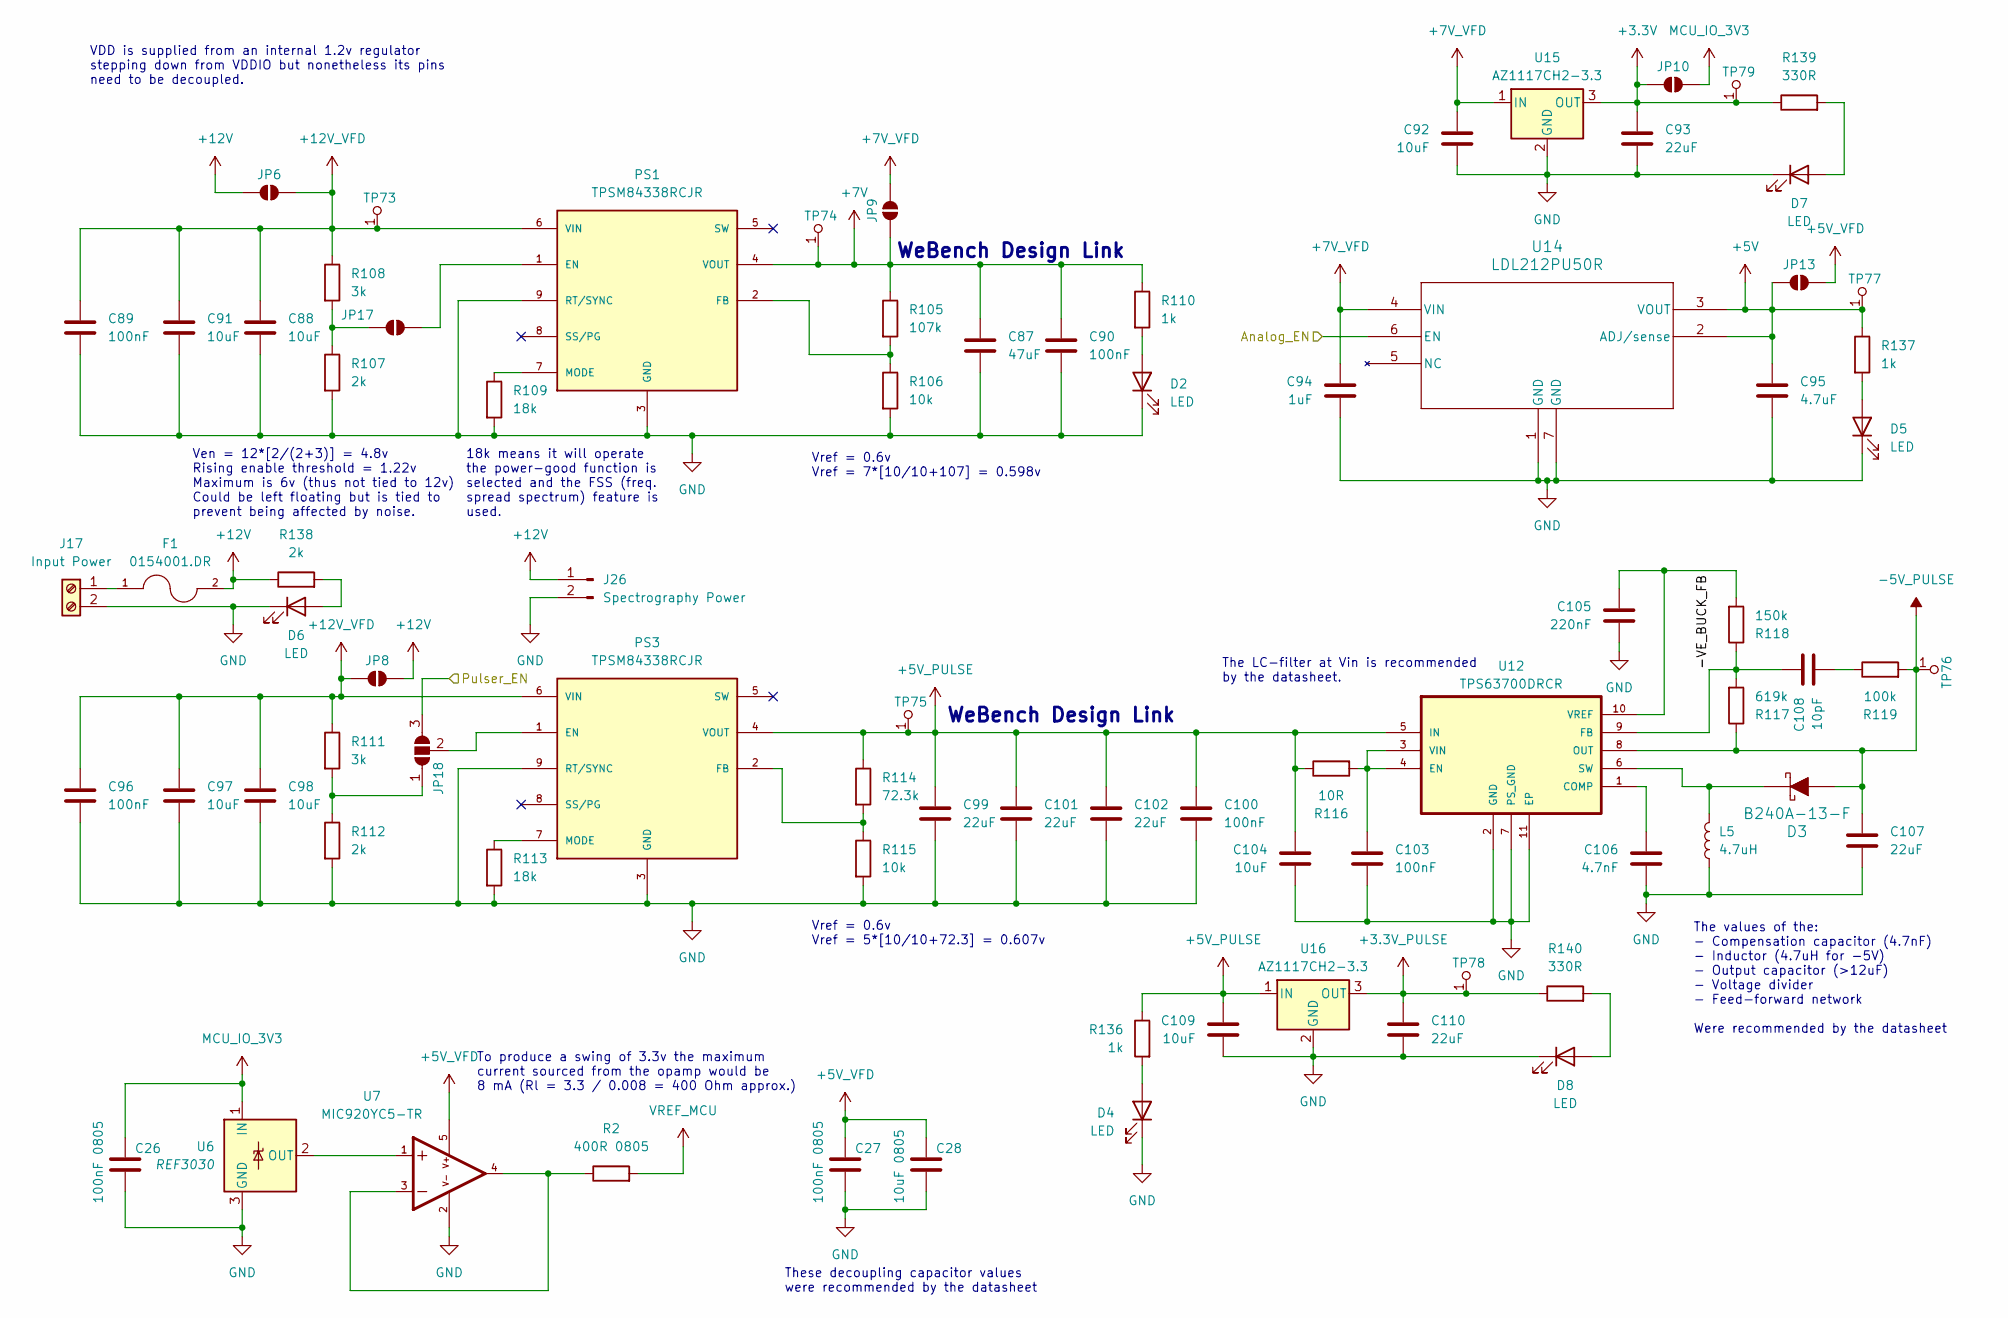
[picture p9: schematic power.kicad_sch]

Parts:
C26, C27: 100nF 0805; C_0603_1608Metric
C28: 10uF 0805; C_0603_1608Metric
C87: 47uF; C_1210_3225Metric
C88, C91, C92, C97, C98, C104, C109: 10uF; C_0805_2012Metric
C89, C90, C96, C100, C103: 100nF; C_0603_1608Metric
C93, C99, C101, C102, C107, C110: 22uF; C_0805_2012Metric
C94: 1uF; C_0603_1608Metric
C95: 4.7uF; C_0805_2012Metric
C105: 220nF; C_0603_1608Metric
C106: 4.7nF; C_0603_1608Metric
C108: 10pF; C_0603_1608Metric
D2, D4, D5, D6, D7, D8: LED; LED_0805_2012Metric
D3: B240A-13-F; DO-214AC; MPN B240A-13-F; Digi-Key_PN B240A-FDICT-ND
F1: 0154001.DR; FUSE_0154001.DR; PARTREV GD
J17: Input Power; TerminalBlock_MaiXu_MX126-5.0-02P_1x02_P5.00mm
J26: Spectrography Power; PinHeader_1x02_P2.54mm_Vertical
JP6, JP8, JP9, JP10, JP13: SolderJumper_2_Open; SolderJumper-2_P1.3mm_Open_RoundedPad1.0x1.5mm
JP17: SolderJumper_2_Open; SolderJumper-2_P1.3mm_Open_Pad1.0x1.5mm
JP18: SolderJumper_3_Open; SolderJumper-3_P1.3mm_Open_Pad1.0x1.5mm
L5: 4.7uH; L_0805_2012Metric
PS1, PS3: TPSM84338RCJR; CONV_TPSM84338RCJR; PARTREV November 2024
R2: 400R 0805; R_0603_1608Metric
R105: 107k; R_0603_1608Metric
R106, R115: 10k; R_0603_1608Metric
R107, R112, R138: 2k; R_0603_1608Metric
R108, R111: 3k; R_0603_1608Metric
R109, R113: 18k; R_0603_1608Metric
R110, R136, R137: 1k; R_0603_1608Metric
R114: 72.3k; R_0603_1608Metric
R116: 10R; R_0603_1608Metric
R117: 619k; R_0603_1608Metric
R118: 150k; R_0603_1608Metric
R119: 100k; R_0603_1608Metric
R139, R140: 330R; R_0603_1608Metric
TP73, TP74, TP75, TP76, TP77, TP78, TP79: RCT-0C; PROBE_PAD_0805; MPN RCT-0C; Digi-Key_PN A106144CT-ND
U6: REF3030; SOT-23
U7: MIC920YC5-TR; SOT65P210X110-5N; PARTREV March 2006
U12: TPS63700DRCR; VREG_V62_16624-01YE
U14: LDL212PU50R; DFN_2PU50R_STM
U15, U16: AZ1117CH2-3.3; SOT-223-3_TabPin2

Connections:
+3.3V: C93.1, JP10.1 (A), R139.1, TP79.1, U15.3 (OUT)
+3.3V_PULSE: C110.1, R140.1, TP78.1, U16.3 (OUT); also elsewhere on the board
+5V: C95.1, JP13.1 (A), R137.1, TP77.1, U14.2 (ADJ/sense), U14.3 (VOUT)
+5V_PULSE: C99.1, C100.1, C101.1, C102.1, C104.1, C109.1, PS3.4 (VOUT), R114.1, R116.1, R136.1, TP75.1, U12.5 (IN), U16.1 (IN); also elsewhere on the board
+5V_VFD: C27.1, C28.1, JP13.2 (B), U7.5; also elsewhere on the board
+7V: C87.1, C90.1, JP9.1 (A), PS1.4 (VOUT), R105.1, R110.1, TP74.1
+7V_VFD: C92.1, C94.1, JP9.2 (B), U14.4 (VIN), U15.1 (IN); also elsewhere on the board
+12V: F1.2, J26.1, JP6.1 (A), JP8.2 (B), R138.1
+12V_VFD: C88.1, C89.1, C91.1, C96.1, C97.1, C98.1, JP6.2 (B), JP8.1 (A), PS1.6 (VIN), PS3.6 (VIN), R108.1, R111.1, TP73.1; also elsewhere on the board
-5V_PULSE: C107.1, D3.A, R117.1, R119.2, TP76.1, U12.8 (OUT); also elsewhere on the board
/Main MCU Section/Analog_EN: U14.6 (EN); also elsewhere on the board
/Main MCU Section/Pulser_EN: JP18.3 (B); also elsewhere on the board
/Power Section/-VE_BUCK_FB: C108.1, R117.2, R118.1, U12.9 (FB)
GND: C26.2, C27.2, C28.2, C87.2, C88.2, C89.2, C90.2, C91.2, C92.2, C93.2, C94.2, C95.2, C96.2, C97.2, C98.2, C99.2, C100.2, C101.2, C102.2, C103.2, C104.2, C105.2, C106.2, C107.2, C109.2, C110.2, D2.1 (K), D4.1 (K), D5.1 (K), D6.1 (K), D7.1 (K), D8.1 (K), J17.2, J26.2, L5.1, PS1.3 (GND), PS1.9 (RT/SYNC), PS3.3 (GND), PS3.9 (RT/SYNC), R106.2, R107.2, R109.2, R112.2, R113.2, R115.2, U6.3 (GND), U7.2, U12.2 (GND), U12.7 (PS_GND), U12.11 (EP), U14.1 (GND), U14.7 (GND), U15.2 (GND), U16.2 (GND); also elsewhere on the board
MCU_IO_3V3: C26.1, JP10.2 (B), U6.1 (IN); also elsewhere on the board
unnamed: C108.2, R119.1
unnamed: D2.2 (A), R110.2
unnamed: D4.2 (A), R136.2
unnamed: D5.2 (A), R137.2
unnamed: D6.2 (A), R138.2
unnamed: D7.2 (A), R139.2
unnamed: D8.2 (A), R140.2
unnamed: F1.1, J17.1
unnamed: JP17.1 (A), R107.1, R108.2
unnamed: JP17.2 (B), PS1.1 (EN)
unnamed: JP18.1 (A), R111.2, R112.1
unnamed: JP18.2 (C), PS3.1 (EN)
unnamed: PS1.2 (FB), R105.2, R106.1
unnamed: PS1.7 (MODE), R109.1
unnamed: PS3.2 (FB), R114.2, R115.1
unnamed: PS3.7 (MODE), R113.1
unnamed: R2.1, U7.3, U7.4
unnamed: U6.2 (OUT), U7.1
unnamed: C106.1, U12.1 (COMP)
unnamed: C103.1, R116.2, U12.3 (VIN), U12.4 (EN)
unnamed: D3.K, L5.2, U12.6 (SW)
unnamed: C105.1, R118.2, U12.10 (VREF)
VREF_MCU: R2.2; also elsewhere on the board

Notes on the sheet:
Vref = 0.6v Vref = 7*[10/10+107] = 0.598v
18k means it will operate the power-good function is selected and the FSS (freq. spread spectrum) feature is used.
WeBench Design Link
VDD is supplied from an internal 1.2v regulator stepping down from VDDIO but nonetheless its pins need to be decoupled.
Vref = 0.6v Vref = 5*[10/10+72.3] = 0.607v
The values of the: - Compensation capacitor (4.7nF) - Inductor (4.7uH for -5V) - Output capacitor (>12uF) - Voltage divider - Feed-forward network Were recommended by the datasheet
To produce a swing of 3.3v the maximum current sourced from the opamp would be 8 mA (Rl = 3.3 / 0.008 = 400 Ohm approx.)
Ven = 12*[2/(2+3)] = 4.8v Rising enable threshold = 1.22v Maximum is 6v (thus not tied to 12v) Could be left floating but is tied to prevent being affected by noise.
The LC-filter at Vin is recommended by the datasheet.
These decoupling capacitor values were recommended by the datasheet

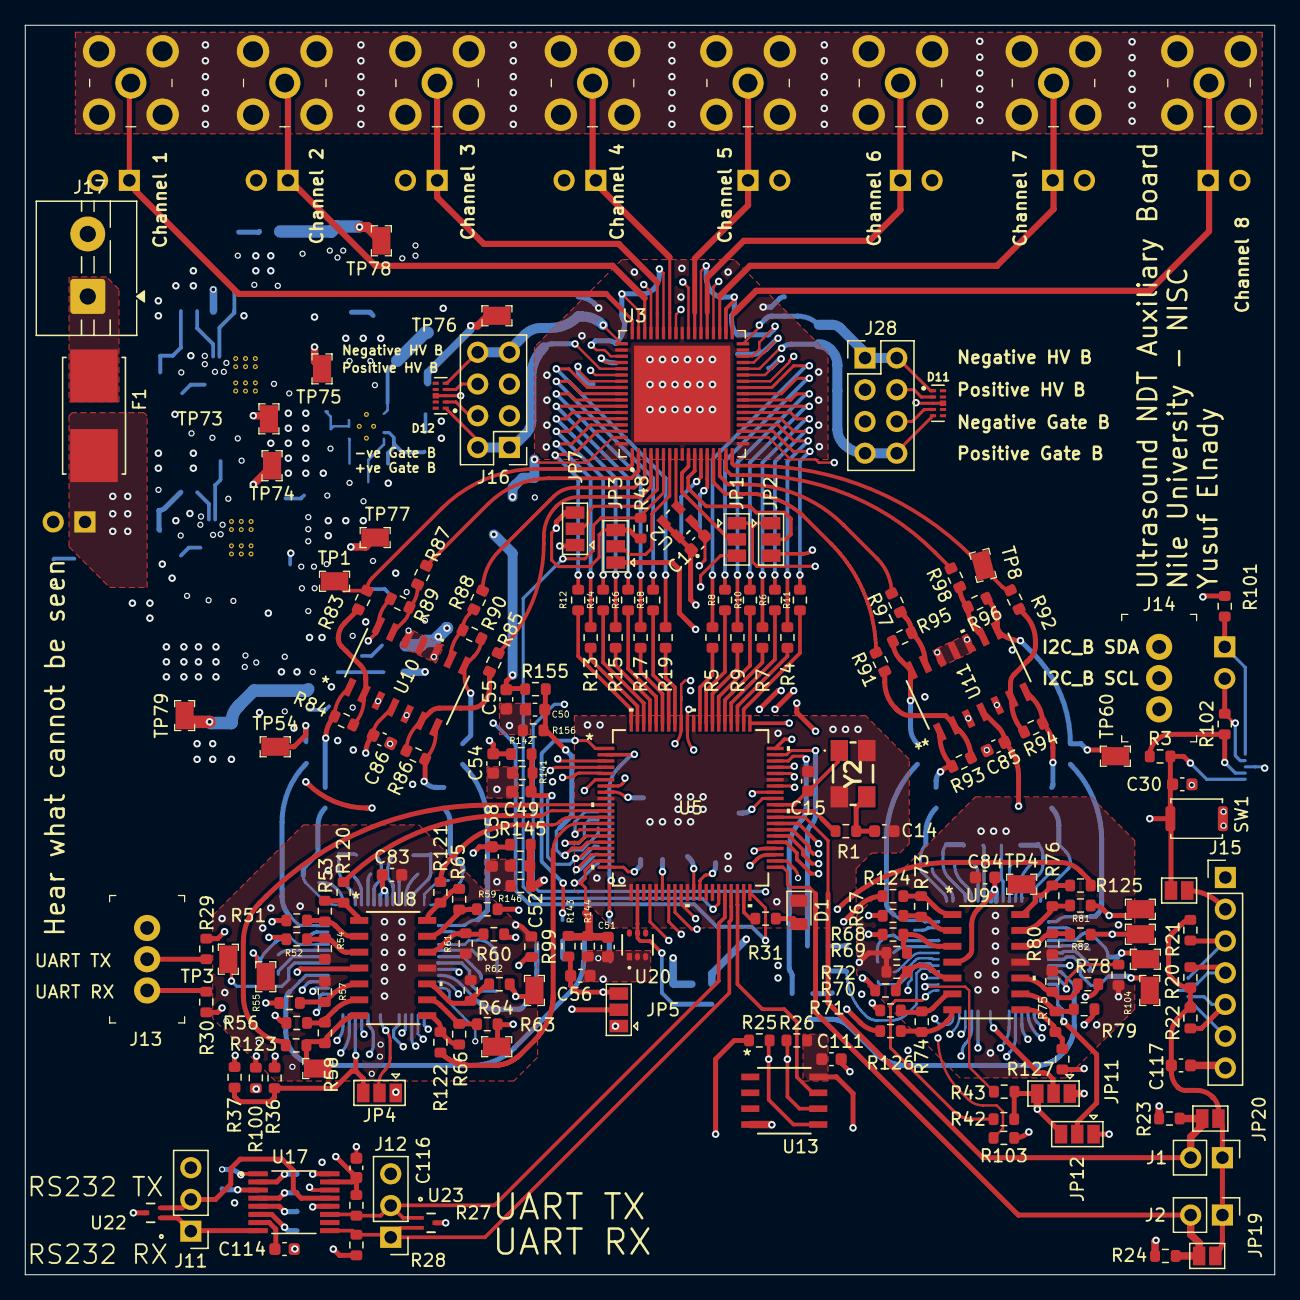
[picture p10: board Ultrasound_NDT.kicad_pcb from above]

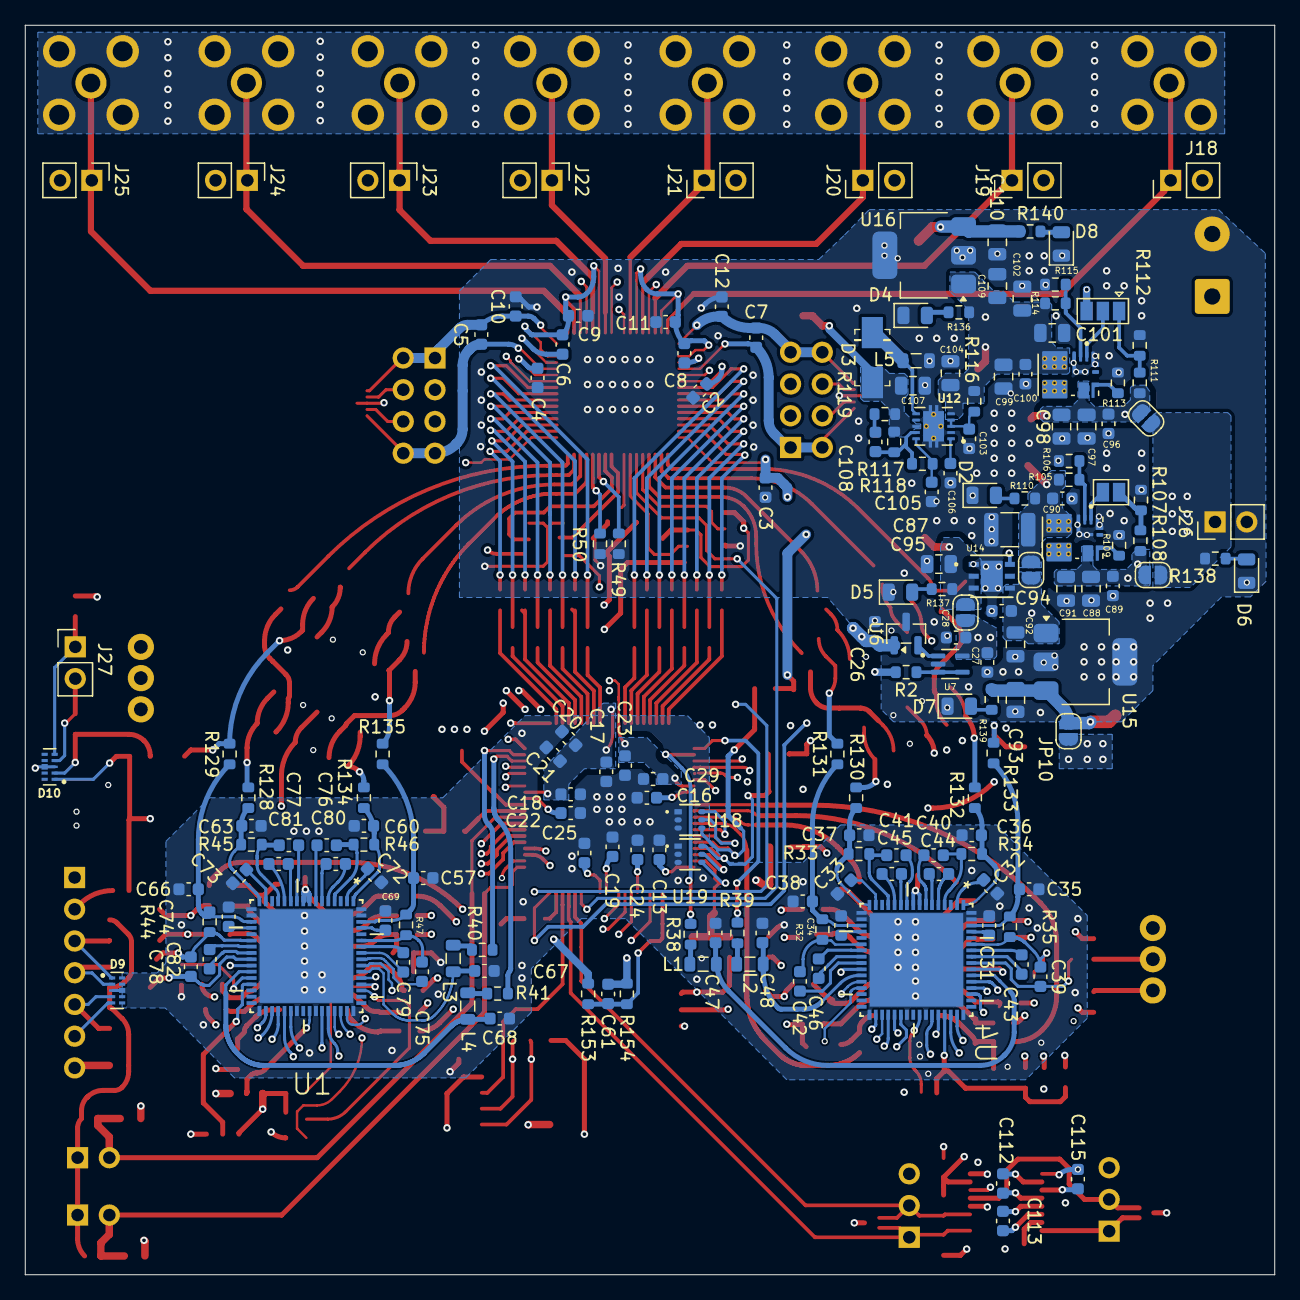
[picture p11: board Ultrasound_NDT.kicad_pcb from below]

Board: 6 copper layers, 100.0 x 100.0 mm, 371 parts (178 on the bottom side), 278 nets.
