yusufElnady/Ultrasound-Auxiliary-Board/(commit log)

2025-11-30 first upload, 60% done
    [MCU.kicad_sch, Ultrasound_NDT.kicad_pcb, Ultrasound_NDT.kicad_sch, power.kicad_sch, pulser.kicad_sch, receiver.kicad_sch, wireless.kicad_sch]
2025-12-04 finished pulser & mcu, receiver & power remaining
    [MCU.kicad_sch, pulser.kicad_sch, receiver.kicad_sch]
2025-12-09 converted diff signals to single-ended, modified pulser & MCU, power untouched
    [MCU.kicad_sch, Ultrasound_NDT.kicad_sch, pulser.kicad_sch, receiver.kicad_sch]
2025-12-15 finished analog signal chain, added main power components, complete the schematic and form a power budget table
    [MCU.kicad_sch, Ultrasound_NDT.kicad_sch, power.kicad_sch, pulser.kicad_sch, receiver.kicad_sch]
2025-12-15 finished 50% of power section, 50% remaining + EEPROM & revision
    [MCU.kicad_sch, PowerBudgetCalculations.xlsx, Ultrasound_NDT.kicad_sch, power.kicad_sch]
2025-12-17 95% done, only headers for communication & power are remaining + RS232 transceiver & 1.5v reference
    [MCU.kicad_sch, Ultrasound_NDT.kicad_sch, power.kicad_sch]
2025-12-17 DONE (inshallah)
    [MCU.kicad_sch, power.kicad_sch, pulser.kicad_sch, receiver.kicad_sch]
2025-12-21 started layout, 20-30% done
    [MCU.kicad_sch, Ultrasound_NDT.kicad_pcb, power.kicad_sch, pulser.kicad_sch, receiver.kicad_sch]
2025-12-23 finished 70% of the layout, only power is remaining + matching parts with each other (analog)
    [MCU.kicad_sch, Ultrasound_NDT.kicad_pcb]
2025-12-23 finished laying out all individual blocks, integration comes next, updated schematic
    [Ultrasound_NDT.kicad_pcb]
2025-12-25 fininshed 90% placement, only power section needs refinement, next sprint the stackup will be decided, probably 6 layers
    [Ultrasound_NDT.kicad_pcb, receiver.kicad_sch]
2025-12-25 Finished placement & started routing, check on stackup & see routing & sigal integrity videos downloaded
    [MCU.kicad_sch, Ultrasound_NDT.kicad_pcb, pulser.kicad_sch]
2025-12-29 started routing, finished 15%
    [MCU.kicad_sch, Ultrasound_NDT.kicad_pcb]
2025-12-29 finished power section, 70% AFE, re-think the stackup and the AFE stage near the MCU
    [Ultrasound_NDT.kicad_pcb, receiver.kicad_sch]
2025-12-31 Finished 70% fr this time, power planes are remaining and some minor connections to the AFE's power & cfg pins, dont forget xrst
    [MCU.kicad_sch, Ultrasound_NDT.kicad_pcb, receiver.kicad_sch]
2026-01-01 1/4 AFE edits left to go, check if MCU ADC channels could be swapped (use oth ADCs), add voltage monitoring & power planes
    [Ultrasound_NDT.kicad_pcb, receiver.kicad_sch]
2026-01-11 5% left, rearrange ADC channels for right AFE
    [MCU.kicad_sch, Ultrasound_NDT.kicad_pcb, power.kicad_sch, pulser.kicad_sch, receiver.kicad_sch]
2026-01-12 re-arranged ADC channels, add voltage monitoring and connect remaining nets
    [MCU.kicad_sch, Ultrasound_NDT.kicad_pcb]
2026-01-13 added voltage monitoring, negative HV remaining & their routing + minimal editing
    [MCU.kicad_sch, Ultrasound_NDT.kicad_pcb, pulser.kicad_sch]
2026-01-14 finished routing YAY! only negative voltage monitoring & DRC & ERC are remaining
    [MCU.kicad_sch, Ultrasound_NDT.kicad_pcb]
2026-01-15 did DRC, negative voltage monitoring & AI revision are remaining
    [Ultrasound_NDT.kicad_pcb]
2026-01-18 added test points & fuse
    [MCU.kicad_sch, Ultrasound_NDT.kicad_pcb, power.kicad_sch, pulser.kicad_sch, receiver.kicad_sch]
2026-02-01 DONE! Added ESD protection & finalized everything before, this thing is ready for production
    [MCU.kicad_sch, Ultrasound_NDT.kicad_pcb, aux_board_BOM.csv, pulser.kicad_sch, wireless.kicad_sch]
2026-02-02 edited voltage sensing resistor values to give headroom
    [MCU.kicad_sch]
2026-03-03 Several finishing updates to fit stocks & changed SMA from SMD to THT, updated schematics too
    [JLCPCB_BOM.xls, MCU.kicad_sch, PCBWAY_BOM.xlsx, PCBWAY_QUOTE1.xls, Sample-BOM_JLCSMT.xlsx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]
2026-04-02 updated manufacturing files
    [BOM_JLCSMT.xlsx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]
2026-05-07 added SMA 3d models, cleaned folder and added system diagram to schematic
    [MCU.kicad_sch, PCBWAY_BOM.xlsx, Sample-BOM_JLCSMT.xlsx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]
